system76/thelio/Thelio Prime N1(nebula19)/Thelio Main Signal Wiring/Dual 4 pin dupont.jpeg

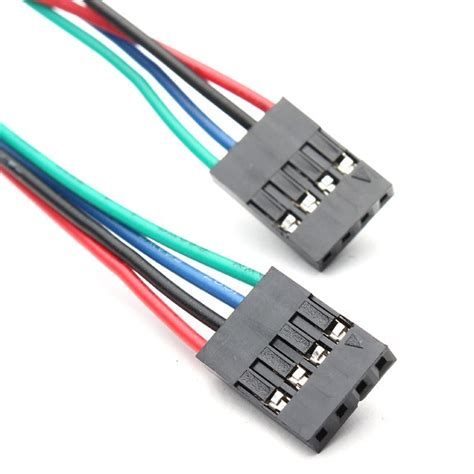
Thelio Prime N1(nebula19)/Thelio Main Signal Wiring/Dual 4 pin dupont.jpeg
