system76/thelio/Thelio Prime N2/README.md

# Thelio Prime N2

## OSHWA Numbers

- Thelio Prime N2: US002861

## Parts Index

| Part Number | Part Name |
|---|---|
| PN-000122 | Badge |
| PN-000652 | Front IO Frame |
| PN-000666 | Steel Magnet Tab |
| PN-000676 | Sqare Magnet Washer |
| PN-000688 | Prime Chassis Top |
| PN-000689 | Prime Right Side Mesh |
| PN-000690 | Prime GPU Brace |
| PN-000692 | Prime R5 N2 IO Shield |
| PN-000693 | Prime Punched Left External Panel |
| PN-000694 | Prime Front Glass Panel |
| PN-000695 | Prime Foot Bar |
| PN-000696 | Prime Mesh Right External Magnet Bracket |
| PN-000697 | Prime Top Magnet Bracket |
| PN-000698 | Prime Small PCI Bracket |
| PN-000699 | Prime Punched Left External Magnet Bracket |
| PN-000700 | Prime Bottom PEM Panel |
| PN-000701 | Prime PCI Mount |
| PN-000703 | Prime Chassis Front |
| PN-000705 | Prime Chassis Bottom |
| PN-000706 | Prime Bottom Fan Bracket |
| PN-000707 | Prime Top Fan Brace |
| PN-000708 | Prime Right Panel Filter Bracket |
| PN-000709 | Prime Chassis Rear |
| PN-000710 | Prime Chassis Main |
| PN-000711 | Prime Mesh Right External Panel |
| PN-000713 | Prime PSU Access Panel |
| PN-000714 | Prime Bottom Magnetic Bracket |
| PN-000715 | Prime PCI Mounting Bracket |
