system76/thelio/Thelio Mira/Thelio Mira/README.md

# Thelio Mira

## OSHWA Numbers

- Thelio Mira: US002790 

| Part Number | Part Name |
|---|---|
| PN-000122 | Badges-tabbed |
| PN-000518 | Drive Cage Cover |
| PN-000520 | Drive Cage |
| PN-000634 | Chassis Bottom |
| PN-000635 | GPU Bracket |
| PN-000636 | Bottom Rear Guide Bracket |
| PN-000637 | GPU Mounting Slot Bracket |
| PN-000638 | 3.5 inch Drive Back Plate |
| PN-000639 | 3.5 inch Drive Cover Plate  |
| PN-000640 | 3.5 inch Drive Cage |
| PN-000641 | Mira R4 IO Shield |
| PN-000643 | Chassis Main |
| PN-000644 | Chassis Rear |
| PN-000645 | Chassis Front |
| PN-000646 | Chassis Top |
| PN-000647 | Left External |
| PN-000648 | Right External |
| PN-000650 | Glass Front Panel |
| PN-000651 | Drive Cage Mounting Plate |
| PN-000652 | Front IO Frame |
| PN-000653 | GPU Arm Bracket |
| PN-000654 | GPU Ridge Plate |
| PN-000655 | GPU Finger |
| PN-000656 | PCI Mount |
| PN-000657 | Side Magnetic Tab |
| PN-000658 | Front Pull Tab |
| PN-000659 | PCI Bracket |
| PN-000660 | 1U Slot Cover |
| PN-000661 | Bottom Front Guide Tab |
| PN-000662 | Bottom Magnetic Bracket |
| PN-000663 | Top Magnetic Bracket |
| PN-000664 | 2.5 in Drive Cage Cover |
| PN-000665 | AIO Bracket |
| PN-000666 | Flat Magnet Tab |
| PN-000668 | Side Bottom External Guide  |
| PN-000669 | PCI Bracket Guide |
