system76/thelio/Thelio Massive/CAD/Extrusions/README.md

# Parts Index

| Part Number | Part Name |
|---|---|
| MSVEXTALU-001002 | Rear Right Extrusion |
| MSVEXTALU-002002 | Rear Left Extrusion |
| MSVEXTALU-003002 | Front Left Extrusion |
| MSVEXTALU-004002 | Front Right Extrusion |
