system76/thelio/Thelio Prime N1(nebula19)/CAD/Internal/README.md

# Parts Index

| Part Number | Part Name |
|---|---|
| PN-000009 | PCI Mount |
| PN-000010 | PCI Bracket |
| PN-000505 | CPU Duct Main |
| PN-000506 | CPU Duct Hood |
| PN-000507 | Chassis Main |
| PN-000509 | Chassis Rear Plate |
| PN-000510 | CPU Duct Fan Bracket |
| PN-000515 | Chassis Bottom |
| PN-000517 | Top IO Brace |
| PN-000518 | Chassis Top Brace |
| PN-000557 | 3D Printed Thelio Spacer 2  |
| PN-000558 | 3D Printed Thelio Spacer 1  |
| PN-000567 | Horizontal Brace |
| PN-000584 | GPU Arm |
| PN-000585 | GPU Arm Finger |
| PN-000595 | Thelio-R4 IO Shield |
