system76/thelio/Thelio Mega/N1_US000677/R2/Internal/README.md

# Parts Index

| Part Number | Part Name |
|---|---|
| PN-000024 | Drive Cage Cover |
| PN-000040 | Drive Cage |
| PN-000091 | PCI Mount |
| PN-000092 | Mega Foot Bar |
| PN-000097 | Chassis Bottom |
| PN-000098 | Side Intake Brace Bracket |
| PN-000099 | Chassis Brace |
| PN-000100 | PCI Bracket |
| PN-000101 | PSU Brace |
| PN-000102 | GPU Main Brace |
| PN-000122 | Product Badges |
| PN-000277 | GPU Brace Arm - Straight  |
| PN-000302 | Chassis Rear Plate |
| PN-000304 | CPU Duct Hood |
| PN-000305 | CPU Duct Main |
| PN-000319 | Chassis Main |
| PN-000324 | Case Spacer (Wire Cover)  |
| PN-000459 | CPU Duct Fan Bracket |
| PN-000501 | Side Intake Fan Brace |
