system76/thelio/Thelio Mega/N2_US002652/R3/Internal/README.md

# Parts Index

| Part Number | Part Name |
|---|---|
| PN-000091 | PCI Mount |
| PN-000092 | Mega Foot Bar |
| PN-000100 | PCI Bracket |
| PN-000101 | PSU Brace |
| PN-000102 | GPU Main Brace |
| PN-000122 | Product Badges |
| PN-000277 | GPU Brace Arm - Straight  |
| PN-000335 | Internal Case Brace |
| PN-000459 | CPU Duct Fan Bracket |
| PN-000512 | Drive Cage Cover |
| PN-000525 | Drive Cage |
| PN-000556 | 3D Printed Case Spacer |
| PN-000565 | Chassis Main |
| PN-000566 | Chassis Rear Plate |
| PN-000571 | Chassis Bottom |
| PN-000588 | Fan PCBA Bracket |
| PN-000590 | Chassis Brace |
| PN-000591 | Horizontal Brace |
| PN-000592 | CPU Duct Hood |
| PN-000593 | CPU Duct Main |
| PN-000594 | Mega-R3 IO Shield |
