system76/thelio/Thelio Mega/N3_US002708/R4/Internal/README.md

# Parts Index

| Part Number | Part Name |
|---|---|
| PN-000091 | PCI Mount |
| PN-000100 | PCI Bracket |
| PN-000277 | GPU Brace Arm - Straight  |
| PN-000512 | Drive Cage Cover |
| PN-000525 | Drive Cage |
| PN-000556 | Front Case Spacer |
| PN-000604 | Chassis Main |
| PN-000605 | CPU Intake Duct Hood |
| PN-000606 | CPU Duct Siding |
| PN-000607 | CPU Duct Main |
| PN-000608 | CPU Duct Rear Fan Bracket |
| PN-000609 | Horizontal Brace |
| PN-000610 | Chassis Bottom |
| PN-000611 | Chassis Rear Plate |
| PN-000612 | PSU Chamber |
| PN-000613 | Bottom Stiffener Bracket  |
| PN-000614 | GPU Brace |
| PN-000615 | Top Chassis Brace |
| PN-000616 | Case Spacer |
| PN-000621 | Mega-R4 IO Shield |
