system76/thelio/Thelio Mira/Thelio Mira (nebula36,spark)/CAD/Internal/README.md

# Parts Index

| Part Number | Part Name |
|---|---|
| PN-000094 | 1U PCI Slot Covers |
| PN-000122 | Product Badge |
| PN-000335 | Internal Case Brace |
| PN-000376 | Chassis Top Brace |
| PN-000459 | CPU Duct Fan Bracket |
| PN-000512 | Drive Cage Cover |
| PN-000525 | Drive Cage |
| PN-000526 | Chassis Bottom |
| PN-000527 | Chassis Main |
| PN-000528 | Chassis Rear Plate |
| PN-000529 | CPU Duct Main |
| PN-000530 | CPU Duct Hood |
| PN-000532 | Horizontal Brace |
| PN-000556 | 3D Printed Case Spacer |
| PN-000559 | Drive Cage Spacer |
| PN-000560 | PCI Bracket |
| PN-000561 | PCI Mount |
