system76/thelio/Thelio Mira/Thelio Mira (nebula40,spark,astra)/astra/internal/README.md

# Parts Index

| Part Number | Part Name |
|---|---|
| PN-000597 | Astra IO Shield 10G Ethernet |
| PN-000598 | CPU Duct Main |
| PN-000599 | CPU Duct Hood |
| PN-000600 | CPU Duct Fan Bracket |
| PN-000601 | Astra IO Shield SFP+ |
