system76/thelio/Thelio Mira/Thelio Mira (nebula40,spark,astra)/common/case/README.md

# Parts Index

| Part Number | Part Name |
|---|---|
| PN-000255 | Accent Panel Carrier |
| PN-000259 | Accent Panel |
| PN-000537 | Accent Panel Carrier Holder |
| PN-000577 | Right Side |
| PN-000578 | Left Side |
| PN-000579 | Top Bracket |
