system76/thelio/Thelio Mira/Thelio Mira (nebula40,spark,astra)/common/internal/README.md

# Parts Index

| Part Number | Part Name |
|---|---|
| PN-000094 | 1U PCI Slot Cover |
| PN-000101 | PSU Brace |
| PN-000122 | Product Badge |
| PN-000528 | Chassis Rear Plate |
| PN-000560 | PCI Bracket |
| PN-000561 | PCI Mount |
| PN-000573 | Chassis Top Brace |
| PN-000575 | Chassis Bottom |
| PN-000582 | Horizontal Brace |
| PN-000603 | Chassis Main |
