system76/thelio/Thelio Mira/Thelio Mira (nebula40,spark,astra)/mira,spark,nebula40/internal/README.md

# Parts Index

| Part Number | Part Name |
|---|---|
| PN-000457 | Mira-B4 IO Shield |
| PN-000459 | CPU Duct Fan Bracket |
| PN-000512 | Drive Cage Cover |
| PN-000525 | Drive Cage |
| PN-000530 | CPU Duct Hood |
| PN-000559 | Drive Cage Spacer |
| PN-000562 | Spark-B1 IO Shield |
| PN-000576 | CPU Duct Main |
| PN-000587 | Spark-R1 IO Shield |
