system76/thelio/Thelio Mega/N1_US000677/R1/CAD/Extrusions/README.md

# Parts Index

| Part Number | Part Name |
|---|---|
| MGAEXTALU-001001 | Rear Right Extrusion |
| MGAEXTALU-002001 | Rear Left Extrusion |
| MGAEXTALU-003001 | Front Left Extrusion |
| MGAEXTALU-004001 | Front Right Extrusion |
