system76/thelio/Thelio Prime N1(nebula19)/Thelio Main Power Supply/Thelio Main Power Supply Wires.odt

Power Supply Power Cables

Thelio Main

Spec version 2

All wire lengths specified from the inside of the connectors.

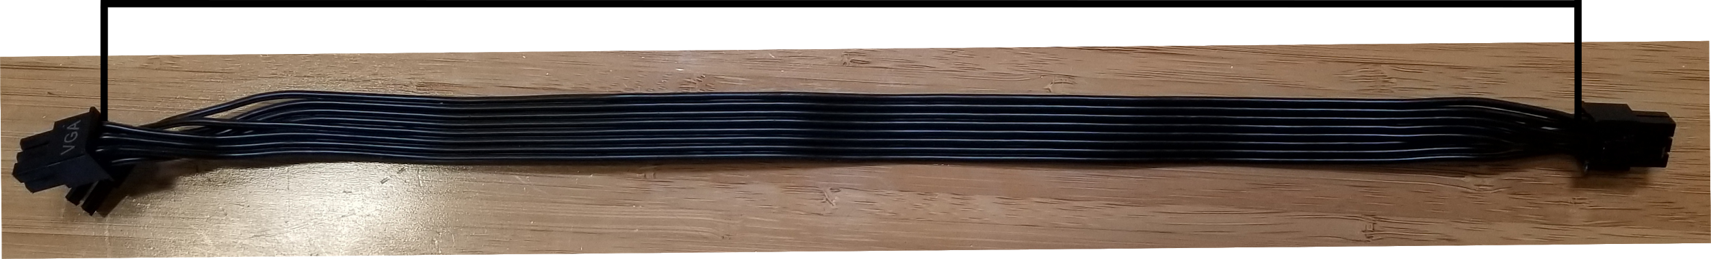
[picture p3: figure]

Cables and connectors are are to be black. Cables are to be braided.

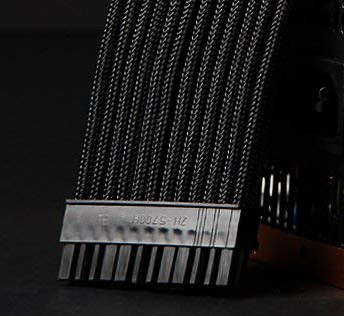
[picture p4: figure]
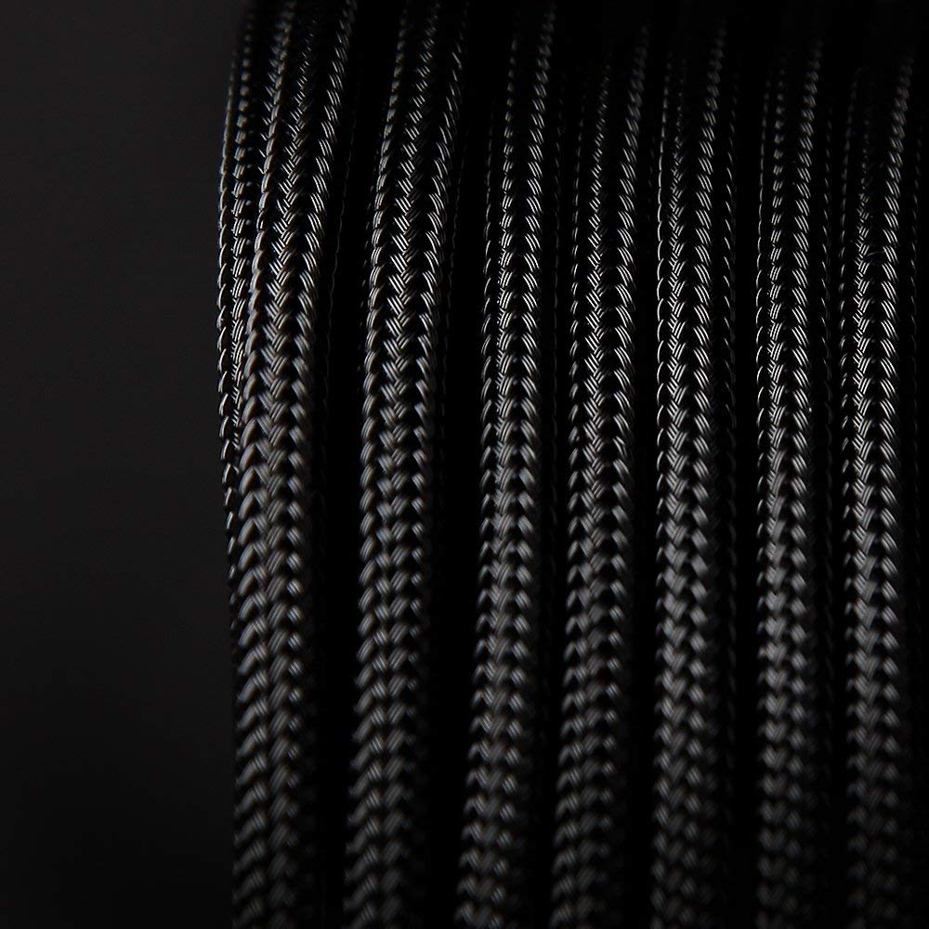
[picture p5: figure]

CPU Power - 520mm

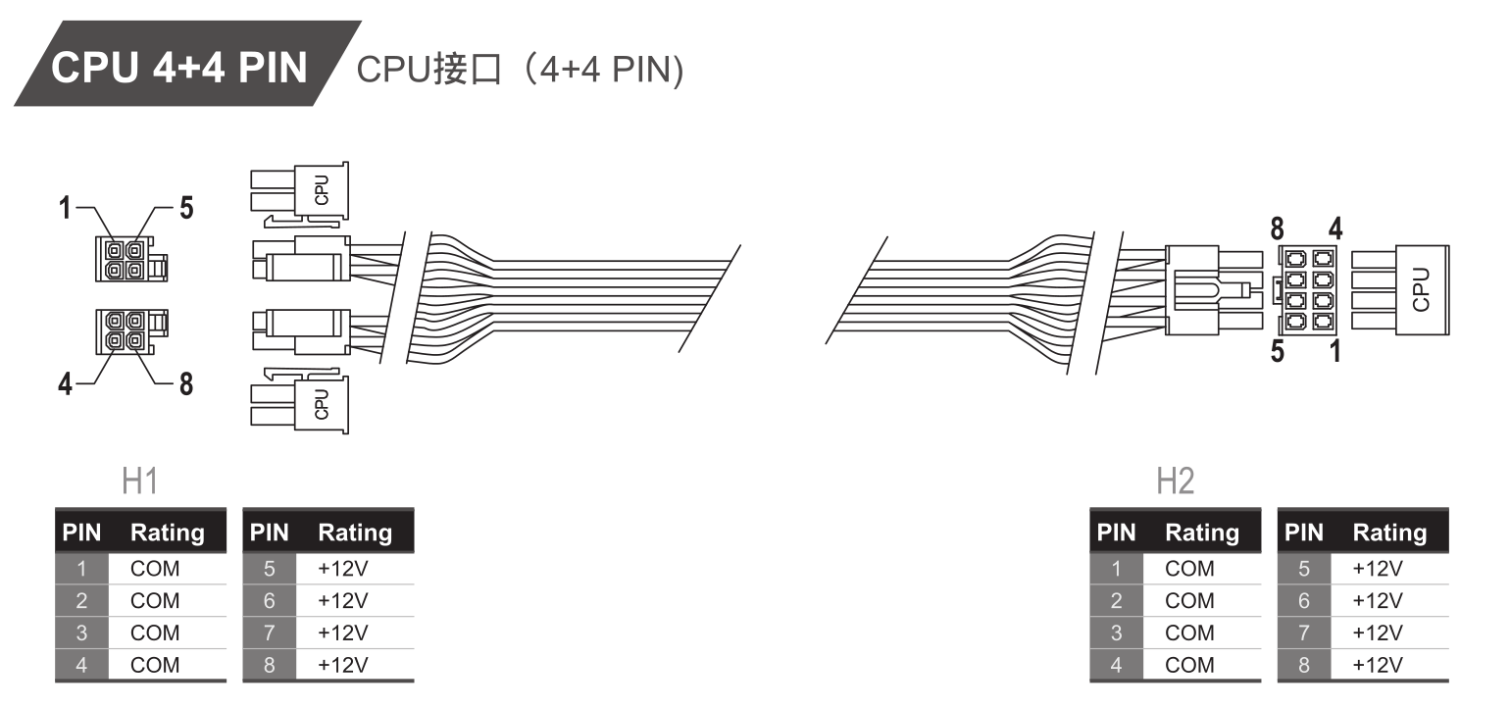
[picture p6: figure]

Mainboard Power - 440mm

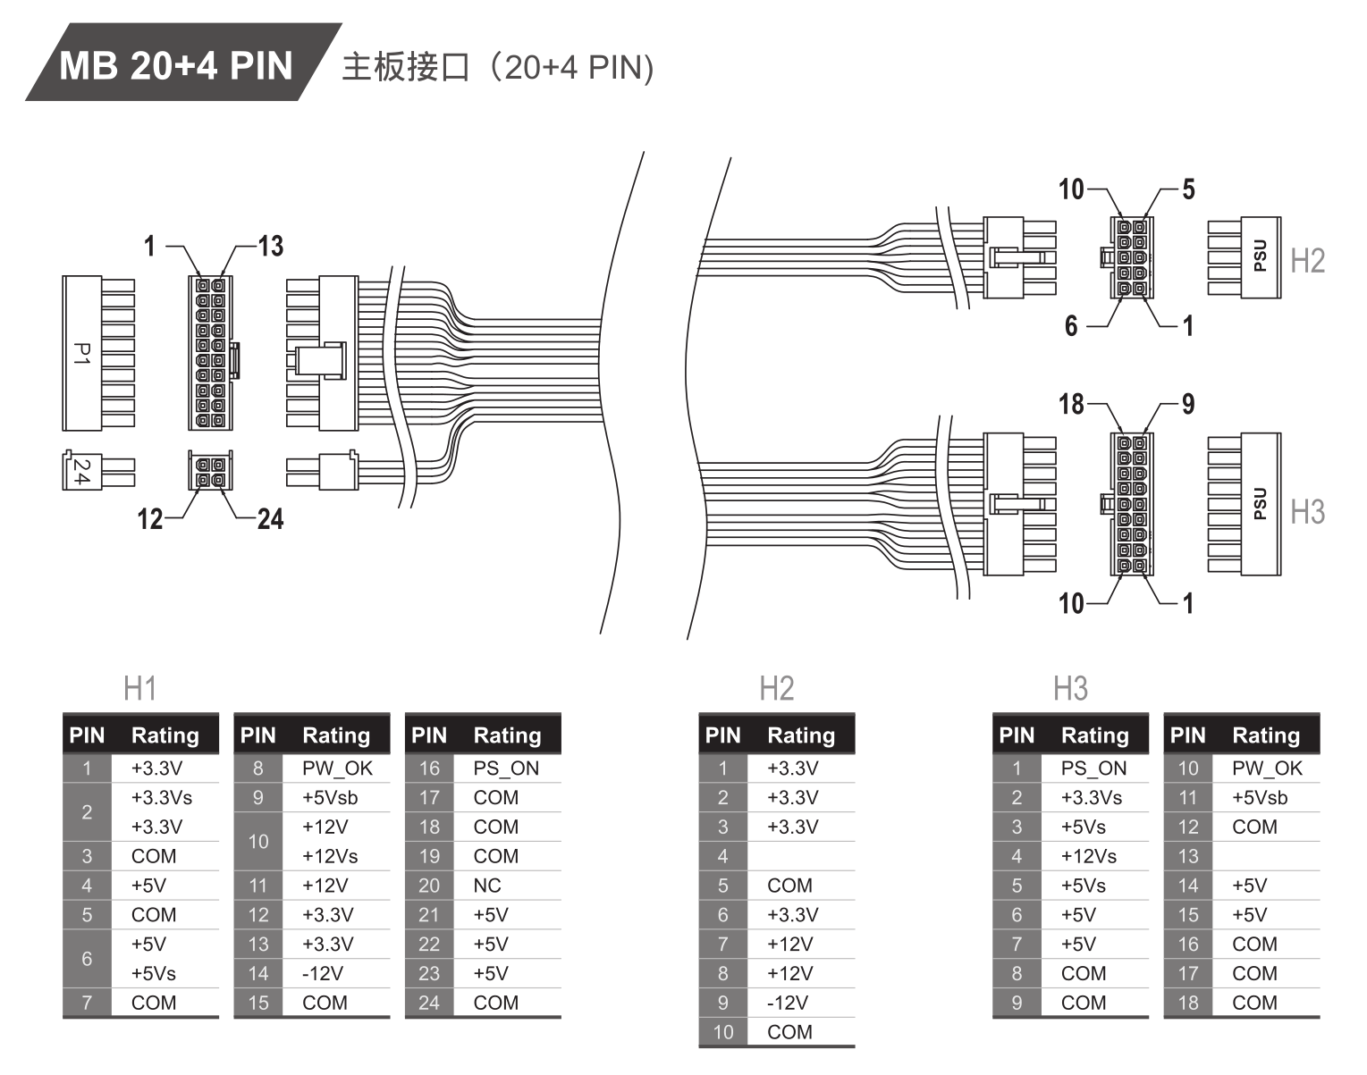
[picture p7: figure]

VGA - 235mm UPDATED - 6 pin PS connector

1 5 6 3
2 6 5 2
3 7 4 1
4 8

Floppy connector - UPDATED - 270mm

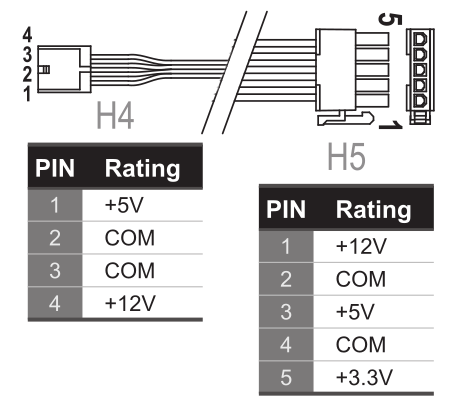
[picture p8: figure]
