system76/thelio/Thelio Major (nebula49)/CAD/Case/README.md

# Parts Index

| Part Number | Part Name |
|---|---|
| PN-000260 | Accent Panel |
| PN-000263 | Accent Panel Carrier |
| PN-000544 | Left Side |
| PN-000545 | Right Side |
| PN-000546 | Accent Panel Carrier Holder |
| PN-000547 | Top |
| PN-000548 | Top Bracket |
