system76/thelio/Thelio Prime N1(nebula19)/CAD/Case/README.md

# Parts Index

| Part Number | Part Name |
|---|---|
| PN-000252 | Accent Panel Carrier |
| PN-000257 | Accent Panel |
| PN-000520 | Accent Panel Carrier Holder |
| PN-000521 | Left Side |
| PN-000522 | Right Side |
| PN-000523 | Top Bracket |
| PN-000524 | Top |
