system76/thelio/Thelio Mira/Thelio Mira (nebula36,spark)/CAD/Case/README.md

# Parts Index

| Part Number | Part Name |
|---|---|
| PN-000255 | Accent Panel Carrier |
| PN-000259 | Accent Panel |
| PN-000533 | Top |
| PN-000534 | Top Bracket |
| PN-000535 | Left Side |
| PN-000536 | Right Side |
| PN-000537 | Accent Panel Carrier Holder |
