system76/thelio/Thelio Common/Screws and standoff/10mm self tapping fan screw.png

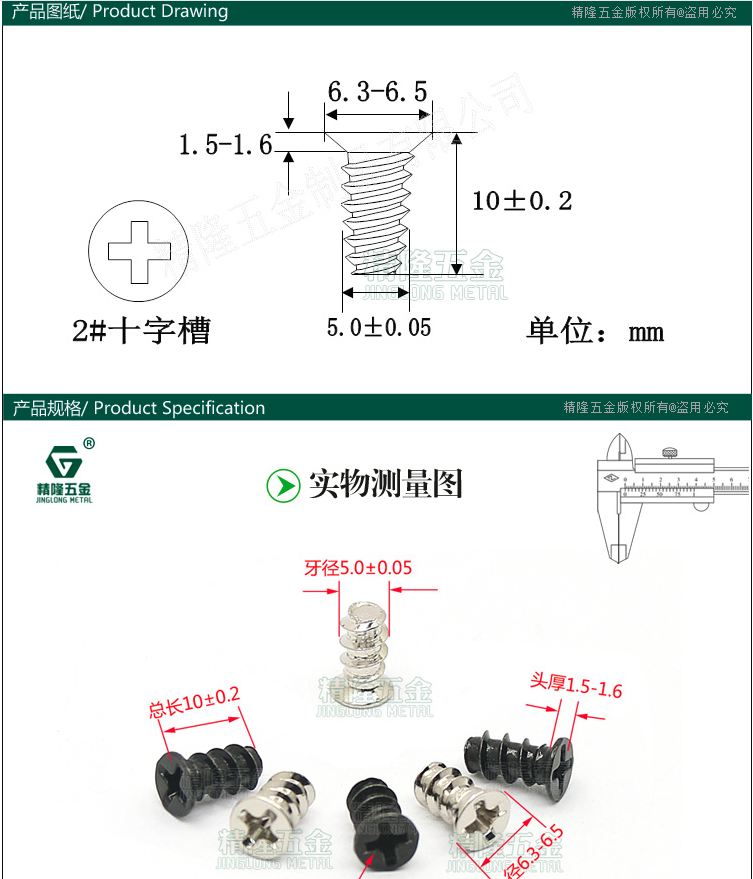
Thelio Common/Screws and standoff/10mm self tapping fan screw.png
