system76/thelio/Thelio Common/Screws and standoff/HD screw gromets.jpg

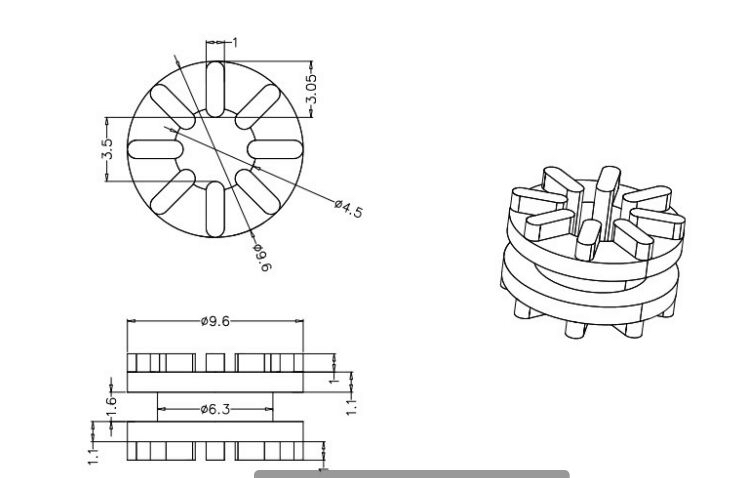
Thelio Common/Screws and standoff/HD screw gromets.jpg
