system76/thelio/Thelio Common/Screws and standoff/M3 HD screws.png

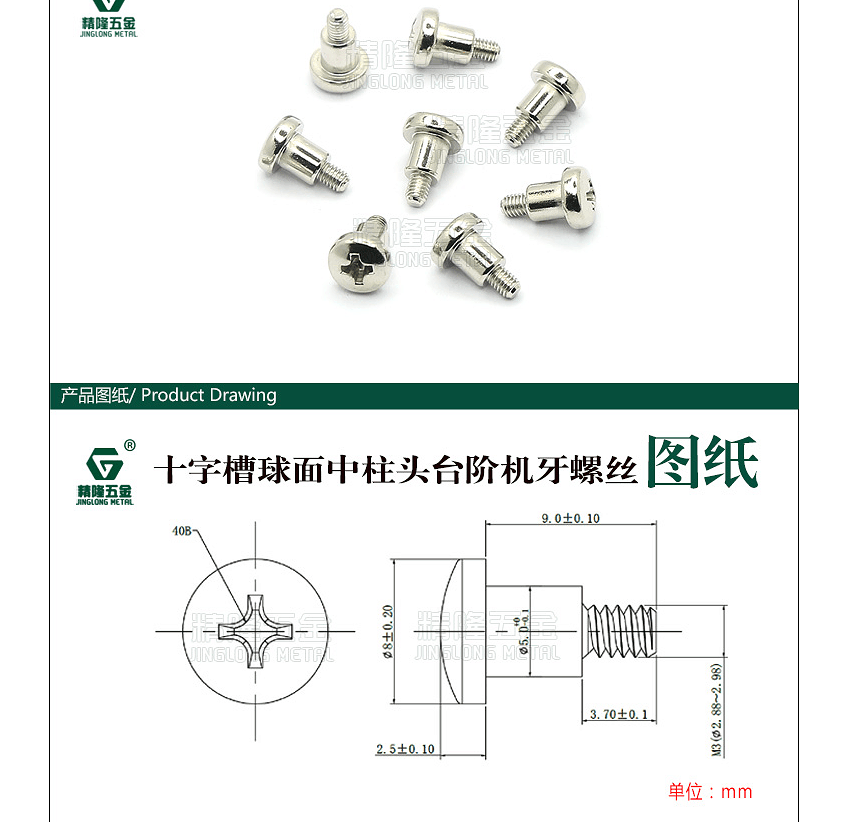
Thelio Common/Screws and standoff/M3 HD screws.png
