system76/thelio/Thelio Common/Screws and standoff/M3 x 10mm thumb screw.png

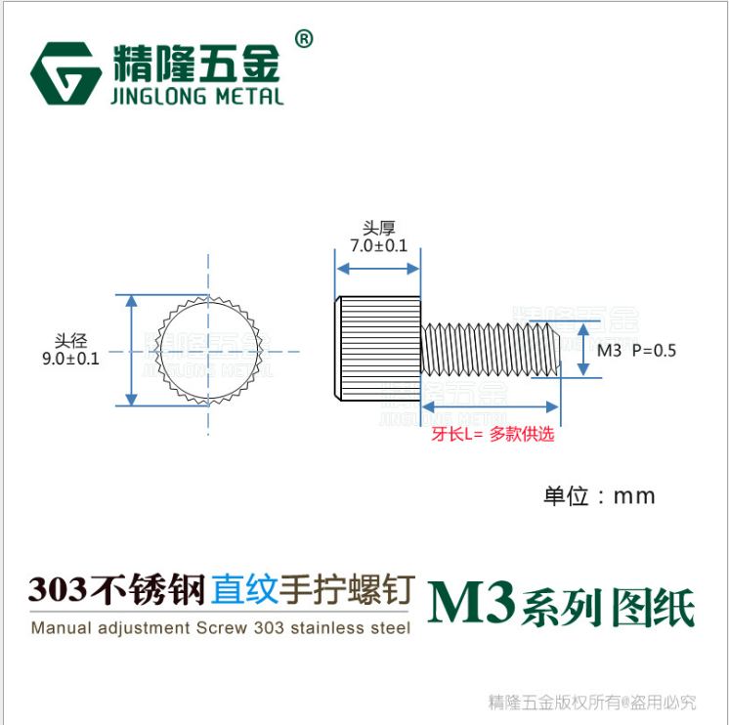
Thelio Common/Screws and standoff/M3 x 10mm thumb screw.png
