system76/thelio/Thelio Common/Screws and standoff/M4 x 10MM standoff.png

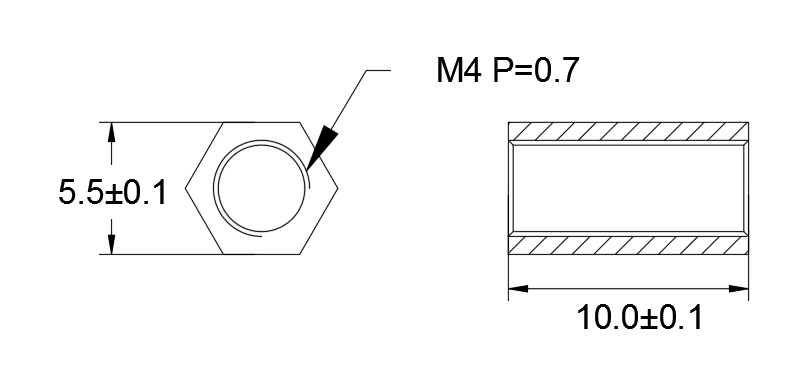
Thelio Common/Screws and standoff/M4 x 10MM standoff.png
