system76/thelio/Thelio Common/Screws and standoff/M4 x.7 x 5 mm screw.png

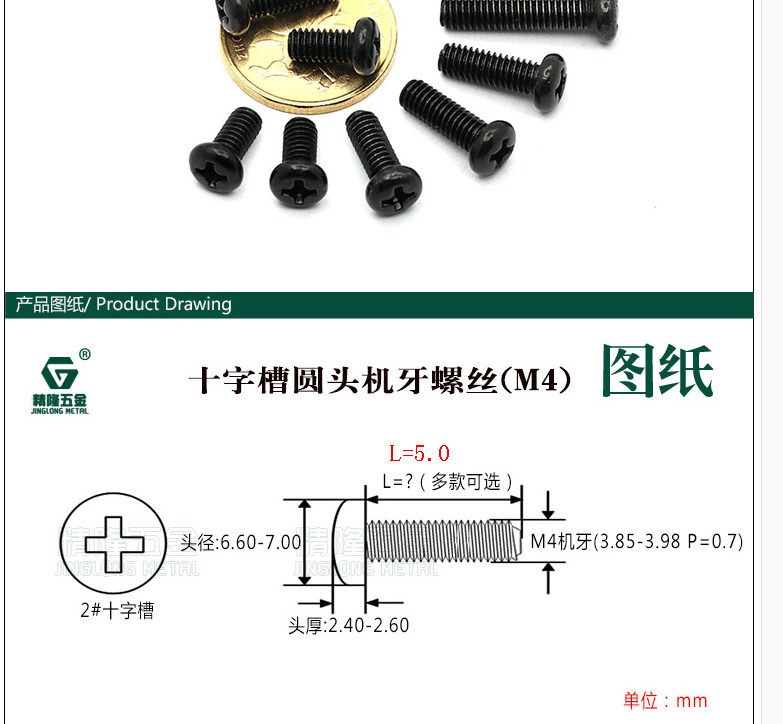
Thelio Common/Screws and standoff/M4 x.7 x 5 mm screw.png
