system76/thelio/Thelio Common/Screws and standoff/rivet.jpg

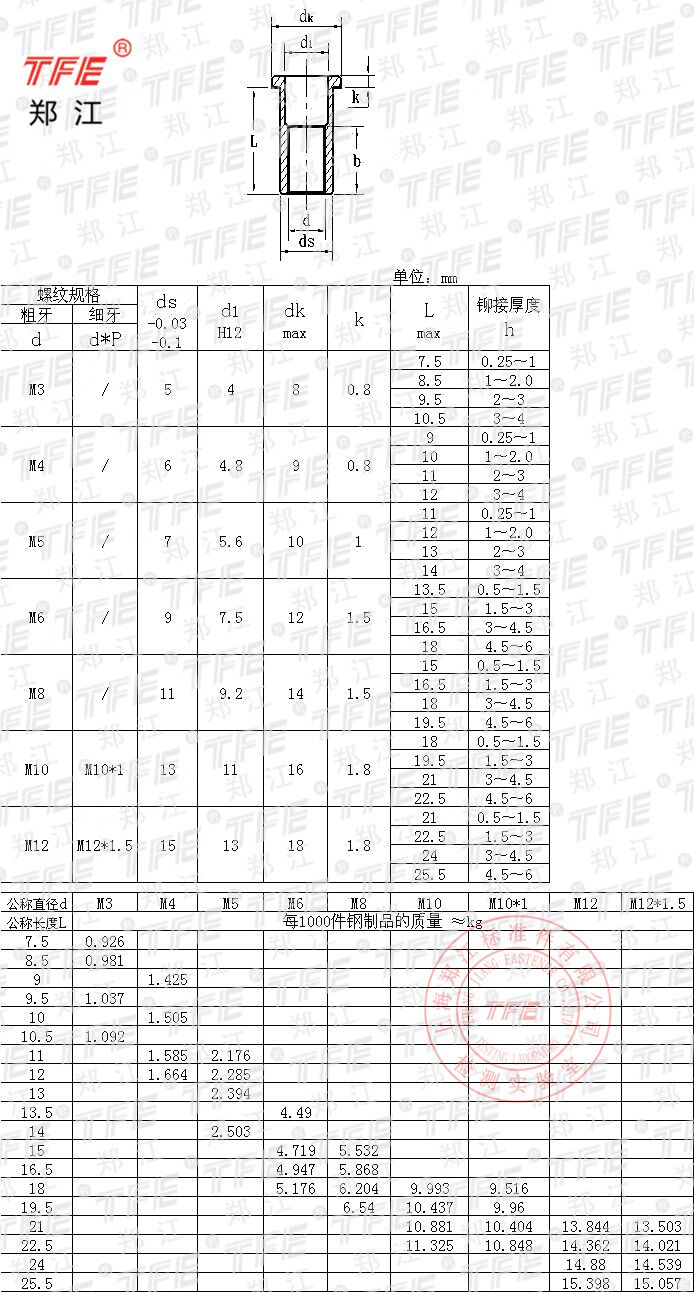
Thelio Common/Screws and standoff/rivet.jpg
