system76/thelio/Thelio Common/Screws and standoff/Steel m3 rivet nuts.png

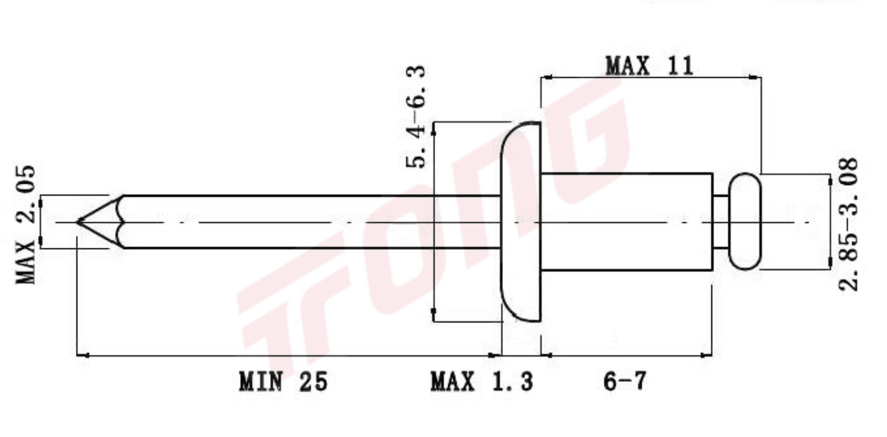
Thelio Common/Screws and standoff/Steel m3 rivet nuts.png
