system76/thelio/Thelio Common/Wireless Antennas/internal wireless spec.png

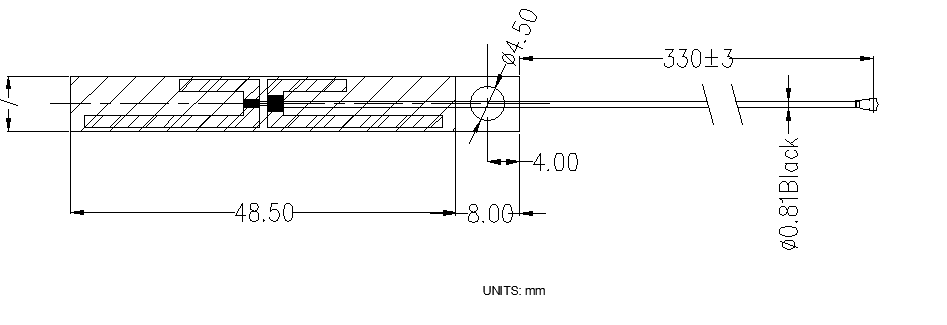
Thelio Common/Wireless Antennas/internal wireless spec.png
