system76/thelio/Thelio Common/Fan Spacers and Wireless Signal Window/140MM Fan Spacer.dxf

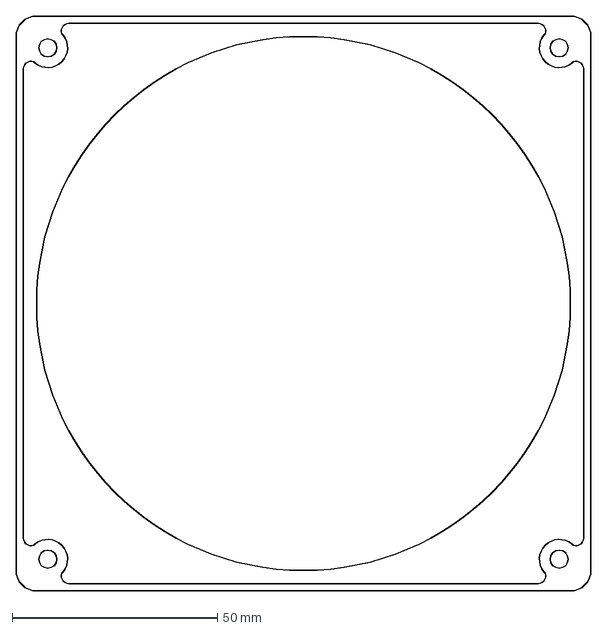
[picture p18: CAD file, 2018-11-01]
Thelio Common/Fan Spacers and Wireless Signal Window/140MM Fan Spacer.dxf
140.0 x 140.0 mm
