system76/thelio/Thelio Common/Fan Spacers and Wireless Signal Window/120MM Fan Spacer.dxf

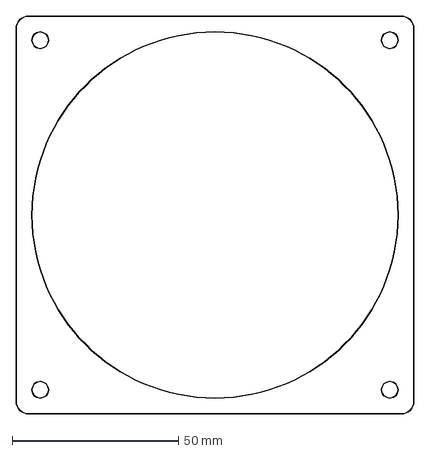
[picture p19: CAD file, 2018-11-01]
Thelio Common/Fan Spacers and Wireless Signal Window/120MM Fan Spacer.dxf
119.5 x 119.5 mm
