system76/thelio/Thelio Common/Fan Spacers and Wireless Signal Window/Thelio Wifi Window.dxf

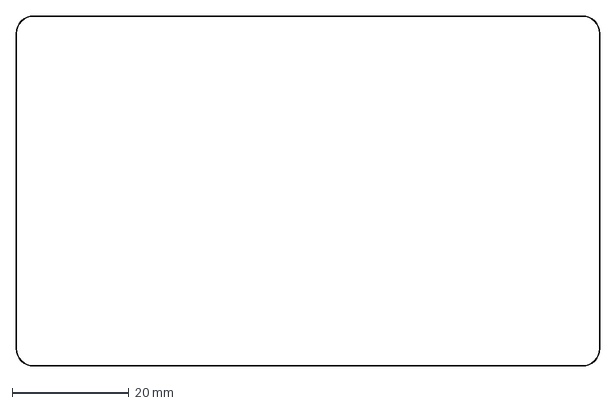
[picture p20: CAD file, 2018-11-01]
Thelio Common/Fan Spacers and Wireless Signal Window/Thelio Wifi Window.dxf
100.0 x 60.0 mm
