system76/thelio/(list of files, cad)

Other CAD files:
Thelio Mega/N3_US002708/R4/Mega R4 Component Assembly v55.step
Thelio Mira/Thelio Mira (nebula40,spark,astra)/common/internal/Mira Extended Assembly (N3) v16.step
Thelio Prime N2/Prime R5 N2 Assembly.step
Thelio Mira/Thelio Mira/Mira Magnet Assembly.step
Thelio Mira/Thelio Mira/2x cage assembly v20.step
Thelio Common/Power Button Mount/Pwr_Button_Mount_Lower.step
Thelio Common/Thelio Foot/PN-000438 & PN-000437 v3.step
Thelio Common/Top IO/Top IO Mockup v11.step
Thelio Major (nebula49)/CAD/Case/PN-000547 v21.step
Thelio Major (nebula49)/CAD/Internal/PN-000540 v33.step
Thelio Massive/CAD/Extrusions/MSVEXTALU-004002.step
Thelio Massive/CAD/STEP External/MSVALU-004003.step
Thelio Massive/CAD/STEP Internal/MGAALU-012012.step
Thelio Mega/N1_US000677/R1/CAD/Extrusions/MGAEXTALU-002001.step
Thelio Mega/N1_US000677/R1/CAD/STEP External/MAJALU-017004 v3.step
Thelio Mega/N1_US000677/R1/CAD/STEP Internal R1/MGAALU-026001.step
Thelio Mega/N1_US000677/R1/CAD/V1-1.step
Thelio Mega/N1_US000677/R2/Internal/PN-000122 v12.step
Thelio Mega/N2_US002652/R3/Internal/PN-000593 v5.step
Thelio Mega/N3_US002708/R4/Internal/PN-000612 v9.step
Thelio Mira/Thelio Mira (nebula36,spark)/CAD/Case/PN-000535 v24.step
Thelio Mira/Thelio Mira (nebula36,spark)/CAD/Internal/PN-000561 v20.step
Thelio Mira/Thelio Mira (nebula40,spark,astra)/astra/case/PN-000596 v2.step
Thelio Mira/Thelio Mira (nebula40,spark,astra)/astra/internal/PN-000601 v5.step
Thelio Mira/Thelio Mira (nebula40,spark,astra)/common/case/PN-000259 v2.step
Thelio Mira/Thelio Mira (nebula40,spark,astra)/common/internal/PN-000603 v2.step
Thelio Mira/Thelio Mira (nebula40,spark,astra)/mira,spark,nebula40/case/PN-000580 v2.step
Thelio Mira/Thelio Mira (nebula40,spark,astra)/mira,spark,nebula40/internal/PN-000587 v22.step
Thelio Mira/Thelio Mira/PN-000648 v17.step
Thelio Prime N1(nebula19)/CAD/Case/PN-000257 v3.step
Thelio Prime N1(nebula19)/CAD/Internal/PN-000506 v21.step
Thelio Prime N2/PN_000696 v13.step
Thelio Common/Power Button Mount/Pwr_Button_Mount_Upper.step
Thelio Major (nebula49)/CAD/Case/PN-000545 v9.step
Thelio Major (nebula49)/CAD/Internal/PN-000367 v32.step
Thelio Massive/CAD/Extrusions/MSVEXTALU-002002.step
Thelio Massive/CAD/STEP External/MSVALU-001002.step
Thelio Massive/CAD/STEP Internal/MGAALU-018005.step
Thelio Mega/N1_US000677/R1/CAD/Extrusions/MGAEXTALU-003001.step
Thelio Mega/N1_US000677/R1/CAD/STEP External/MAJALU-016004 v3.step
Thelio Mega/N1_US000677/R1/CAD/STEP Internal R1/MGAFIL-003001.step
Thelio Mega/N1_US000677/R2/Internal/PN-000091 v12.step
Thelio Mega/N2_US002652/R3/Internal/PN-000590 v9.step
Thelio Mega/N3_US002708/R4/Internal/PN-000621 v7.step
Thelio Mira/Thelio Mira (nebula36,spark)/CAD/Case/PN-000259 v2.step
Thelio Mira/Thelio Mira (nebula36,spark)/CAD/Internal/PN-000335 v7.step
Thelio Mira/Thelio Mira (nebula40,spark,astra)/astra/internal/PN-000599 v8.step
Thelio Mira/Thelio Mira (nebula40,spark,astra)/common/case/PN-000255 v15.step
Thelio Mira/Thelio Mira (nebula40,spark,astra)/common/internal/PN-000575 v12.step
Thelio Mira/Thelio Mira (nebula40,spark,astra)/mira,spark,nebula40/internal/PN-000562 v11.step
Thelio Mira/Thelio Mira/External Magnet Con Holder v6.step
Thelio Prime N1(nebula19)/CAD/Case/PN-000252 v17.step
Thelio Prime N1(nebula19)/CAD/Internal/PN-000557 v2.step
Thelio Prime N2/PN_000698 v3.step
Thelio Major (nebula49)/CAD/Case/PN-000548 v26.step
Thelio Major (nebula49)/CAD/Internal/PN-000543 v21.step
Thelio Massive/CAD/Extrusions/MSVEXTALU-003002.step
Thelio Massive/CAD/STEP External/MSVALU-012006.step
Thelio Massive/CAD/STEP Internal/MSVALU-006004.step
Thelio Mega/N1_US000677/R1/CAD/Extrusions/MGAEXTALU-001001.step
Thelio Mega/N1_US000677/R1/CAD/STEP External/MGAALU-004001.step
Thelio Mega/N1_US000677/R1/CAD/STEP Internal R1/MGAFIL-004001.step
Thelio Mega/N1_US000677/R2/Internal/PN-000101 v15.step
Thelio Mega/N2_US002652/R3/Internal/PN-000592 v3.step
Thelio Mega/N3_US002708/R4/Internal/PN-000556 v5.step
Thelio Mira/Thelio Mira (nebula36,spark)/CAD/Case/PN-000537 v7.step
Thelio Mira/Thelio Mira (nebula36,spark)/CAD/Internal/PN-000094 v19.step
Thelio Mira/Thelio Mira (nebula40,spark,astra)/astra/internal/PN-000598 v13.step
Thelio Mira/Thelio Mira (nebula40,spark,astra)/common/case/PN-000577 v2.step
Thelio Mira/Thelio Mira (nebula40,spark,astra)/mira,spark,nebula40/internal/PN-000576 v8.step
Thelio Mira/Thelio Mira/Lower Foot v4.step
Thelio Prime N1(nebula19)/CAD/Case/PN-000520 v3.step
Thelio Prime N1(nebula19)/CAD/Internal/PN-000585 v13.step
Thelio Prime N2/PN_000122 v12.step
Thelio Major (nebula49)/CAD/Case/PN-000544 v19.step
Thelio Major (nebula49)/CAD/Internal/PN-000541 v21.step
Thelio Massive/CAD/Extrusions/MSVEXTALU-001002.step
Thelio Massive/CAD/STEP External/MAJALU-016004.step
Thelio Massive/CAD/STEP Internal/MGAALU-020002.step
Thelio Mega/N1_US000677/R1/CAD/Extrusions/MGAEXTALU-004001.step
Thelio Mega/N1_US000677/R1/CAD/STEP External/MGAALU-001001.step
Thelio Mega/N1_US000677/R1/CAD/STEP Internal R1/MGAALU-012007.step
Thelio Mega/N1_US000677/R2/Internal/PN-000319 v18.step
Thelio Mega/N2_US002652/R3/Internal/PN-000594 v12.step
Thelio Mega/N3_US002708/R4/Internal/PN-000605 v11.step
Thelio Mira/Thelio Mira (nebula36,spark)/CAD/Case/PN-000534 v28.step
Thelio Mira/Thelio Mira (nebula36,spark)/CAD/Internal/PN-000376 v24.step
Thelio Mira/Thelio Mira (nebula40,spark,astra)/astra/internal/PN-000597 v14.step
Thelio Mira/Thelio Mira (nebula40,spark,astra)/common/case/PN-000579 v2.step
Thelio Mira/Thelio Mira (nebula40,spark,astra)/common/internal/PN-000122 v12.step
Thelio Mira/Thelio Mira (nebula40,spark,astra)/mira,spark,nebula40/internal/PN-000457 v17.step
Thelio Mira/Thelio Mira/PN-000634 v11.step
Thelio Prime N1(nebula19)/CAD/Case/PN-000522 v13.step
Thelio Prime N1(nebula19)/CAD/Internal/PN-000567 v7.step
Thelio Prime N2/PN_000694 v8.step
Thelio Major (nebula49)/CAD/Case/PN-000263 v6.step
Thelio Major (nebula49)/CAD/Internal/PN-000542 v25.step
Thelio Massive/CAD/STEP External/MSVALU-003004.step
Thelio Massive/CAD/STEP Internal/MGAALU-019005.step
Thelio Mega/N1_US000677/R1/CAD/STEP External/MGAALU-003001.step
Thelio Mega/N1_US000677/R1/CAD/STEP Internal R1/MGAFIL-002001.step
Thelio Mega/N1_US000677/R2/Internal/PN-000277 v2.step
Thelio Mega/N2_US002652/R3/Internal/PN-000588 v5.step
Thelio Mega/N3_US002708/R4/Internal/PN-000606 v11.step
Thelio Mira/Thelio Mira (nebula36,spark)/CAD/Case/PN-000255 v15.step
Thelio Mira/Thelio Mira (nebula36,spark)/CAD/Internal/PN-000559 v4.step
Thelio Mira/Thelio Mira (nebula40,spark,astra)/astra/internal/PN-000600 v6.step
Thelio Mira/Thelio Mira (nebula40,spark,astra)/common/case/Mira Case N3 - Accent case extended 40 mm v3.step
Thelio Mira/Thelio Mira (nebula40,spark,astra)/common/internal/PN-000582 v5.step
Thelio Mira/Thelio Mira (nebula40,spark,astra)/mira,spark,nebula40/internal/PN-000530 v17.step
Thelio Mira/Thelio Mira/PN_000668 v7.step
Thelio Prime N1(nebula19)/CAD/Case/PN-000524 v25.step
Thelio Prime N1(nebula19)/CAD/Internal/PN-000558 v2.step
Thelio Prime N2/PN_000697 v10.step
Thelio Major (nebula49)/CAD/Case/PN-000260 v1.step
Thelio Major (nebula49)/CAD/Internal/PN-000539 v18.step
Thelio Massive/CAD/STEP External/MSVALU-012005.step
Thelio Massive/CAD/STEP Internal/MSVALU-010006.step
Thelio Mega/N1_US000677/R1/CAD/STEP External/MGAALU-002001.step
Thelio Mega/N1_US000677/R1/CAD/STEP Internal R1/MGAALU-025002.step
Thelio Mega/N1_US000677/R2/Internal/PN-000102 v14.step
Thelio Mega/N2_US002652/R3/Internal/PN-000591 v8.step
Thelio Mega/N3_US002708/R4/Internal/PN-000277 v2.step
Thelio Mira/Thelio Mira (nebula36,spark)/CAD/Case/PN-000536 v15.step
Thelio Mira/Thelio Mira (nebula36,spark)/CAD/Internal/PN-000532 v25.step
Thelio Mira/Thelio Mira (nebula40,spark,astra)/common/case/PN-000537 v7.step
Thelio Mira/Thelio Mira (nebula40,spark,astra)/common/internal/PN-000094 v19.step
Thelio Mira/Thelio Mira (nebula40,spark,astra)/mira,spark,nebula40/internal/PN-000512 v13.step
Thelio Mira/Thelio Mira/PN-000661 v10.step
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
