system76/thelio/Thelio Massive/CAD/STEP External/README.md

# Parts Index

| Part Number | Part Name |
|---|---|
| MAJALU-016004 | Front Bracket |
| MSVALU-001002 | Front Panel |
| MSVALU-002007 | Top Panel |
| MSVALU-003004 | Left Panel |
| MSVALU-004003 | Right Panel |
| MSVALU-012005 | Left Bracket |
| MSVALU-12006 | Right Bracket |
