system76/thelio/Thelio Massive/CAD/STEP Internal/README.md

# Parts Index

| Part Number | Part Name |
|---|---|
| MGAALU-012012 | Horizontal Brace |
| MGAALU-018005 | Drive Cage Panel A |
| MGAALU-019005 | Drive Cage Panel B |
| MGAALU-020002 | Drive Cage Cover |
| MGAALU-021004 | Horizontal Brace Intake Baffle |
| MGAALU-024002 | Foot Bar |
| MGAALU-028001 | PSU Brace |
| MGAFIL-002001 | 3D Printed Horizontal Brace Spacer  |
| MSVALU-000091 | PCI Mount |
| MSVALU-005004 | Chassis Main |
| MSVALU-006004 | Chassis Bottom |
| MSVALU-007004 | Horizontal Brace Extension |
| MSVALU-010006 | CPU Duct |
| MSVALU-013006 | Chassis Top Fan Brace |
| MSVALU-014004 | Horizontal Brace Bracket |
| MSVALU-022003 | PCI Bracket |
