system76/thelio/Thelio Mega/N1_US000677/R1/CAD/STEP External/README.md

# Parts Index

| Part Number | Part Name |
|---|---|
| MAJALU-016004 | Front Bracket |
| MAJALU-017004 | Side Bracket |
| MGAALU-001001 | Front Panel |
| MGAALU-002001 | Top Panel |
| MGAALU-003001 | Left Panel |
| MGAALU-004001 | Right Panel |
