system76/thelio/Thelio Mega/N1_US000677/R1/CAD/STEP Internal R1/README.md

# Parts Index

| Part Number | Part Name |
|---|---|
| MGAALU-009005 | Chassis Main |
| MGAALU-011004 | Chassis Bottom |
| MGAALU-012007 | GPU Brace |
| MGAALU-012010 | Horizontal Brace |
| MGAALU-014005 | Horizontal Brace Bracket |
| MGAALU-017005 | Chassis Top Brace |
| MGAALU-018004 | Drive Cage |
| MGAALU-019002 | Drive Cage Side Panel |
| MGAALU-020002 | Drive Cage Cover |
| MGAALU-021003 | Horizontal Brace Intake Baffle |
| MGAALU-022002 | PCI Bracket |
| MGAALU-023001 | PSU Brace |
| MGAALU-024001 | Foot Bar |
| MGAALU-025002 | Horizontal Brace Drive Screw Cover  |
| MGAALU-026001 | PCI Mount |
| MGAALU-027001 | 2U PCI Slot Cover |
| MGAFIL-001003 | 3D Printed GPU Brace Arm Fingers |
| MGAFIL-002001 | 3D Printed Horizontal Brace Spacer  |
| MGAFIL-003001 | 3D Printed Drive Screw Cover Spacer |
| MGAFIL-004001 | 3D Printed GPU Brace Arm |
