system76/thelio/Thelio Major (nebula49)/Thelio Major Signal Wiring/wireless/wireless antenna.jpg

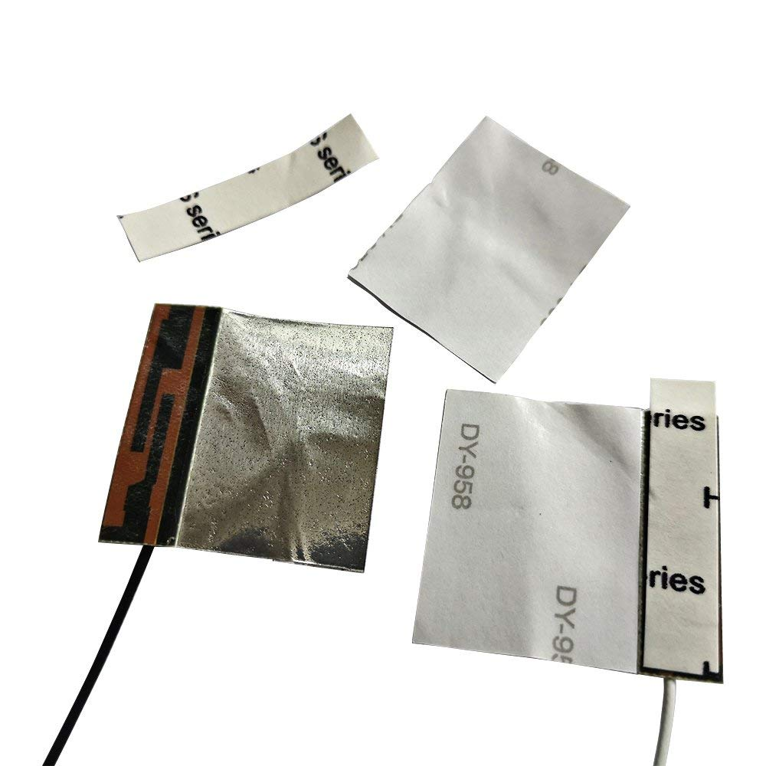
Thelio Major (nebula49)/Thelio Major Signal Wiring/wireless/wireless antenna.jpg
