system76/thelio/Thelio Prime N1(nebula19)/Thelio Main Signal Wiring/hd audio connector.jpg

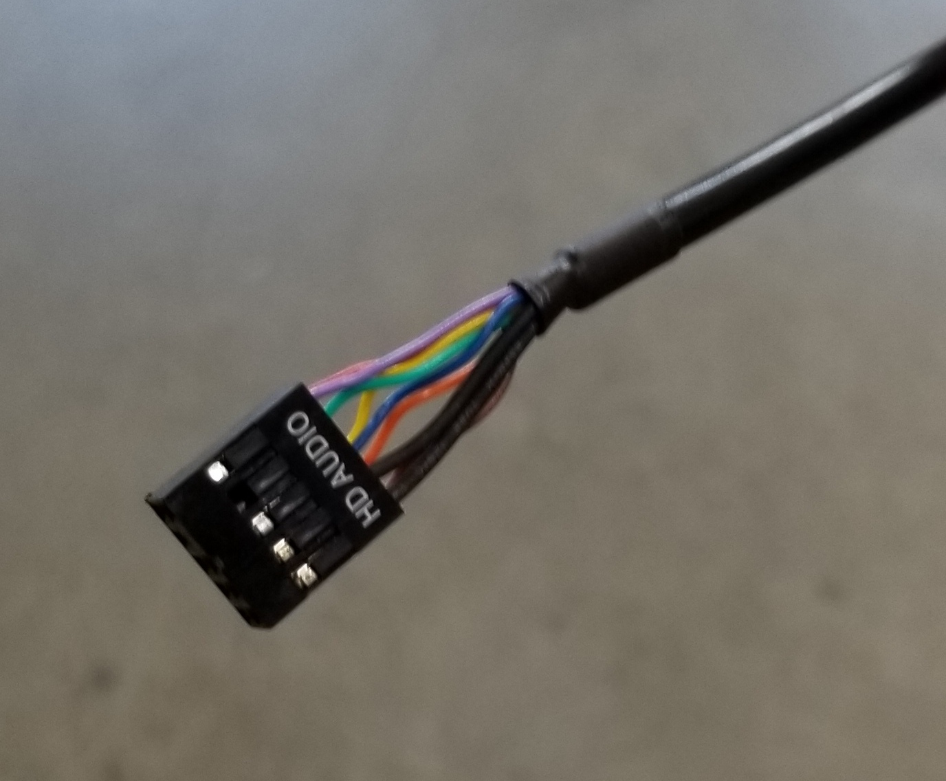
Thelio Prime N1(nebula19)/Thelio Main Signal Wiring/hd audio connector.jpg
