system76/thelio/Thelio Prime N1(nebula19)/Thelio Main Signal Wiring/usb 3.0 female connector.jpg

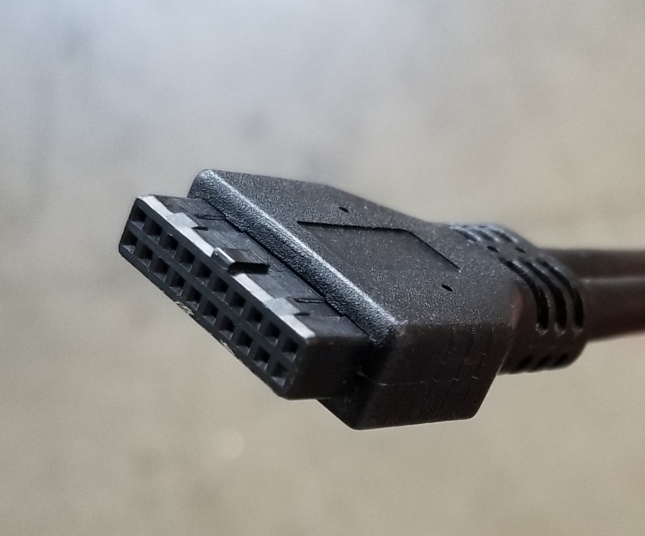
Thelio Prime N1(nebula19)/Thelio Main Signal Wiring/usb 3.0 female connector.jpg
