system76/thelio/(threads)

Thread 3 (2019-02-13):

looking for the ideal (lightweight) laptop for developers

pachamaltese, 2019-02-13:
# Looking for the perfect laptop (for developers)

## Introduction

After your Twitter [reply](https://twitter.com/system76/status/1095449280968617990) here are my thoughts about the perfect laptop.

## Thinkpads

IMO, the best laptops ever created and [MoMA](https://www.moma.org/collection/works/2168) is with me at this. However, after a long discussion with colleagues they could be improved with some small changes.

## Arrow keys

They should be fully sized, even if that requires to enlarge the keyboard area a bit more, as currently most laptops (i.e. Thinkpads) enlarge the bottom edge a bit. The same applies to key such as PgUp and PgDn.

## Fn keys

Unlike most Thinkpad users, my call is that fn button should be right to ctrl button as most users are used to that.

## Touchpad and numerical keyboard

The touchpad should be horizontally centered and there should be no numerical keyboard on a laptop, as it biases both the touchpad and the rest of the keyboard to the left, and therefore it promotes bad muscular habits.

Ideally, a touchpad without buttons is better. If it allows clicking without pressing but just touching, even better.

In an ideal world a good touchpad shall include a button next to it to turn on/off the device for three main purposes:

* saving battery when using the terminal for an extended period
* to disable it to prevent accidental clicking
* you want to save battery and don't need to use the touchpad at the moment

## Backlit keyboard

it helps a lot when it comes with white and/or green light. Red is acceptable while blue it not good at all.

## Display

A 14'' display seems to be ok and it's a relative consensus. Matte display are something really valuable just because glossy screens can stress eyes a lot.

## Processor and graphics

For Linux users, AMD is the way to go. NVIDIA card are problematic. I know Pop OS really simplifies the long fight with drivers, but keeping drivers up to date as it is required by different applications, is really complicated.

## Fingerprint reader

Anything that is Ubuntu-compatible is ok.

## Panel to control devices

In the case of Pop OS (what I use on a Thinkpad), it would be nice to have a panel that allows to disable/enable:

* wifi
* bluetooth
* touchpad
* webcam
* usb ports
* fingerprint reader

I know the wifi on/off function works ok, and it can be extended to other hardware devices.

Thread 4 (2019-03-09):

Graphic cards hanging down due missing holder

magdesign, 2019-03-09:
On my Thelio the graphics card is kind of hanging down.

To fix this, I made the first modification on the case:
Cutting 2x M3 threads and fit in a screw to hold the weight of the cards. See attached pictures.
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

brs17, 2019-03-13:
Thank you for the feedback @magdesign ! We really appreciate it.

Since you received your Thelio, we have since made some changes to the pcie bracket with a similar solution in mind (notice the ridges holding the graphics card up):

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

I expect the team to be in touch with you regarding these changes.

eric-s-raymond, 2019-05-18:
I've seen a similar issue with my Thelio.  Graphics card fell partway out of its slot when I had the machine case off and resting on its front so I could have easy access to the rear-side ports.  Clearly it wan't secured enough.

Closed 2019-05-18.

Thread 10 (2019-05-18):

Thelio case has no labeling on audio I/O jacks

eric-s-raymond, 2019-05-18:
Thelio case has no labeling on audio I/O jacks. This is an epic fail.  If I have to explain why, you should be ashamed of yourselves.

magdesign, 2019-05-18:
At least a sketch to download where all ports are labeled so we can figure out which port is what.

WatchMkr, 2019-05-18:
This is on the Thelio product roadmap.

magdesign, 2019-11-19:
Here is the sketch of which plug is for what:

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

found here on page 21: https://download.gigabyte.com/FileList/Manual/mb_manual_x399-designare-ex_e.pdf

CaryHertert, 2021-07-09:
@jgrano can we call this closed?  or at least duplicated by #22  #23 #26 #28

jgrano, 2021-07-09:
All new product releases are getting port labels.

Closed 2021-07-09.

Thread 11 (2019-05-18):

Thelio case doesn't use a standard I/O cutout on the rear edge.

eric-s-raymond, 2019-05-18:
This is not personally an issue for me.  But I've seen online comments by people who say it's a dealbreaker for them, and you should be aware of that.

WatchMkr, 2019-05-18:
We won't be moving to a I/O shield.

eric-s-raymond, 2019-05-18:
What's the advantage in the way it's done now?

Again, not a personal issue for me, but I am curious about the reasoning.

WatchMkr, 2019-05-18:
In our view, I/O shields don't match with the rest of the system and are best suited for generic off-the-shelf PC cases rather than a complete product.

eric-s-raymond, 2019-05-18:
I think you have dismissed this issue too quickly.

Part what serious technical buyers are looking for when they acquire a high-end system like this is a certain degree of future-proofness; they want to know that they're going to be able to service and upgrade  it whether or not the vendor is there to help.

Such users put less value on what you think of as a "complete product" positioned like consumer electronics and more on the chassis as the base for a portfolio of options.  Not using a standard cutout is a signal that you don't share this concern.  It clashes with the philosophy of open source and modularity you have expressed elsewhere.

I'm trying to put together an issue addressing a related and slightly larger problem: it seems to me that the Thelio's design reveals a somewhat confused product strategy. I'll have more to say about this when I think I can give crisp and actionable advice.

Closed 2019-05-18.

Thread 12 (2019-05-18):

Thelio case ports need visual contrast so they can be found in dim light.

eric-s-raymond, 2019-05-18:
Black port openings on a black case may appeal to skinny-jeans hipster designers by tickling their ooh-minimalism response, but functionally they suck.  Have mercy on people trying to plug in cables in dim light and cramped spaces.

Silk-screen white outlines around the damn things! Either that or make your port panel(s) out of metal with a finish that is *not black*. Visual contrast is everybody's friend here.

WatchMkr, 2019-05-18:
This is on the product roadmap.

Closed 2021-11-22.

Thread 5 (2019-05-18):

Thelio case needs better noise suppression

eric-s-raymond, 2019-05-18:
I recently moved to a Thelio (generously donated by System76!) from a custom-built system with a high-end sort-of-gamer case called an NZXT (Model 700, I think).  I say "sort-of-gamer" because it used design ideas from gamer hotrod systems while obviously being intended for a broader market - lots of focus on maintainability and upgrade-friendliness in the design.

One axis along which that case was well ahead of the Thelio's is sound suppression.  Besides the now-usual 200mm slow-rotation fans. It did two things future revs of the case could usefully copy:

(1) A thin layer of acoustic foam on the inner walls of the case to absorb sound and dampen case vibrations.

(2) Contract points between assemblies are often (not always, but often) but often acoustically damped by rubber grommets or feet.

If you do these things, it is possible for a Thelio-class system to be whisper-quiet. I miss that about my old system.

magdesign, 2019-05-18:
The noise is really an annoying issue which needs to be resolved.
I will try the rubber idea...

WatchMkr, 2019-05-18:
Thank you for the suggestions. We're working on acoustic improvements in Thelio Io firmware (where we've found lots of potential for optimization) and Thelio mechanical design.

eric-s-raymond, 2019-05-18:
Yeah, that relatively thin case top with no damping on the joints to the base could have been designed as a noise ampilifier.  Grommeting at the joints would address this.

magdesign, 2019-05-18:
I removed this:
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

and added some rubber tape on top:
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

Now to noise is a bit less high....

avollmerhaus, 2019-10-15:
How loud does it usually get? I considered buying a Thelio (the little one), but I can't stand fan noise.
I will be doing some compiling on the system (gentoo user), so it would be a real show stopper if the system is noisy all the time.

magdesign, 2019-10-15:
To be honest, its quite noisy!
I added several rubber tape pieces everywhere to make it more silent, but with heavy rendering I  hear the fans and they speed up and down all the time which makes it really annoying. A constant sound would be a bit less nerve killing....
However, I guess its still one of the best opensource system available.

labeledmk, 2019-11-06:
Some flaws in the design acoustically speaking would be no soft gaskets used, the gap between the chassis and the top shell, the fans. Soft gaskets between vibration points such as fans or the cpu shrouds would help some. The design used on the exhaust and bottom intake are cool but they're thin so you need to isolate them from vibrating as much as possible. The gap on the bottom would be helped with some sort of air filter or being closed altogether. Any open point in the system will leak sound and keeping as much sound coming out of the exhaust as possible will help overall perception of audible sound escaping. The fans are trickier it's a combination of blades, bearing, and fan profiles. Better cooler pulling the heat away from the cpu will mean you can get away with lower RPMs. So thermal paste to something higher their could help though I'm not sure what you do use and how it compares.

WatchMkr, 2020-08-28:
Over the past year and a half, we've worked to dramatically improve the acoustic characteristics of Thelio. We can now confidently close this issue. Most of these changes have been in since late last year. We had a couple more fan curves to optimize when COVID hit which delayed our closing of this issue.

Improving Thelio acoustic quality included component, mechanical, and software changes. To begin the process we built a sound proof room in our factory and acquired testing equipment to measure decibels in a controlled environment. This provided the data necessary to establish a baseline and measure the affect of our changes.

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

**Components**

We have moved to entirely Noctua or Be Quiet fans and coolers. They provide rubber dampening and quieter motors. We use both because supply from only one is not consistent enough. However, we have found that their products perform equally well with regard to cooling and acoustics.

A considerable amount of noise for early shipments of Thelio Major and Massive came from the power supply. EVGA power supplies have a "Eco Mode" that must be turned on to enable a fan curve for the power supply. For Major and Massive customers, please check that Eco Mode is turned on if the power supply seems loud. The switch is either on the back or inside on the power supply. Fan curves on power supplies are now required or enabled on all shipments. Enabling Eco Mode has no affect on performance. It's a silly switch that shouldn't exist.

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

**Mechanical**

Fans are now attached to ducts in the system rather than to the coolers. This reduces transit damage and vibrations when paired with rubber dampeners.

Before
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

After (Also notice the chamber now pulls cool air for Major HEDT CPUs directly from the outside of the chassis. This resulted in better performance and quieter operation.)
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

In early Thelio models, there was a gap between the exterior and interior at the bottom of the machine. We extended the sides of the bottom out to seal the top and bottom of the chassis.

Before
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

After
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

**Software**

While components and mechanical changes contributed to improvements, the biggest improvement came from carefully designed fan curves for each class of product. Fan curve optimizations improved system performance and acoustics. This blog post goes into more detail: https://blog.system76.com/post/618130916327456768/keeping-cool-with-thelio-the-secrets-of-thelios

Being that the biggest contributor to improving Thelio acoustic qualities was software, the improvements have shipped to all Thelio customers through software updates to the system76-power package. All curves for all products have now been optimized and the updates shipped.

Closed 2020-08-28.

Thread 6 (2019-05-18):

Thelio case top is way too hard to put back on once removed.

eric-s-raymond, 2019-05-18:
This is my single worst problem with the Thelio case.  I had to remove the case top to clear a cable that had shifted into an unfortunate collision with a fan blade, and despite many tries and much cursing have not succeeded in getting it reassembled.

Take this seriously, please. I've been tinkering with PCs and their cases since the early 1980s and I have *never before* seen one that was this much of a revolving bitch to put together.  Seems like it requires some combination of secret black magic and the dexterity of a neurosurgeon.

I've been running the machine caseless for days now and this is not good.  My office is dusty and without a case and good filters conductive dust *will* eventually get somewhere that will crash it.  (I used to see this happen occasionally with the Thelio's predecessor.)

This problem is serious enough that I am contemplating transplanting the Thelio's guts into my old case to banish it.

I don't have any clear idea how to fix this.

WatchMkr, 2019-05-18:
Thanks for your input. There are certainly ways we can make that an easier experience.

eric-s-raymond, 2019-05-18:
Maybe start with a YouTube video explaining the black magic?

I'm going to wrestle with the fscker some more later today.

brs17, 2019-05-20:
@eric-s-raymond guides/videos for working on Thelio can be found here: https://system76.com/guides

eric-s-raymond, 2019-05-20:
I see links for three Thelio variants there.  How do I tell which one mine is?

WatchMkr, 2019-05-20:
There is a badge on the back of the computer with your model number.

Closed 2019-05-18.

Thread 7 (2019-05-18):

Air intakes need removable dust filters

eric-s-raymond, 2019-05-18:
See issue #6 for backstory.  Without intake filters my Thelio is going to choke on the dust - the question is only when, not if.

When you design these in, do it so that (a) the intake filters slide out for cleaning, and (b) they can be removed and reinserted with the machine in its normal operating position.

My old case had this feature. It was wonderful.

WatchMkr, 2019-05-18:
This is on the roadmap.

Thread 8 (2019-05-18):

Thelio case needs indentations or handles for lifting

eric-s-raymond, 2019-05-18:
Title says it all.

The nice custom Unix epoch zero fan grille on mine is slightly bent inwards because the top of it was the only place my fingers could get purchase when I was trying to shift the thing. I am sad about this.

I don't much care functionally whether the grips or indented portions are fore and aft near the top  of either end of the lower frame or on either side of the case top.  The fore-and-aft placement would probably be better structural engineering, as it would avoid hanging the weight on the lower frame off of six relatively small thumbscrews.

WatchMkr, 2019-05-18:
Thank you for the suggestion. We'll keep this in mind as we continue to iterate the design.

magdesign, 2019-05-18:
May sound a bit silly but,
look out for some old MacPro mid2010 on ebay.
Their case is beautifully designed, very easy to open, everything exchangeable without tools, very silent and they are not in production anymore.... just for inspiration..

eric-s-raymond, 2019-05-18:
Yeah, those middle-period Mac cases were excellent design for usability/maintainability.

If you want real positive differentiation this is the direction I urge you to go - make people think "motherboards age out but I want to keep this case forever".  My old NZXT case is like that.

Thread 9 (2019-05-18):

Thelio case lacks front- or top-mounted USB ports.

eric-s-raymond, 2019-05-18:
Lack of front- or top-mounted USB ports is annoying.

You may not think this is a big deal, but I use a very common Logitech trackball called an m570, a wireless device with a USB radio dongle. It can matter a lot whether that device is on the front, top, or back of the machine, because the low-power radio transceiver has trouble if it's too far away from or not in LOS with the trackball.

You're competing with cases that have  this. It's pretty much a checklist feature for the high-end ones these days; you shouldn't get left behind.

WatchMkr, 2019-05-18:
Front ports are on the product roadmap.

michalsapka, 2022-10-26:
Was this abandoned in the redesign process?

leviport, 2023-10-17:
Front (well, top-front) ports have been added in the latest iteration of the Thelio/Nebula designs: https://github.com/system76/thelio/pull/59

Closed 2023-10-17.

Thread 14 (2019-06-09):

Thelio connector pins for the front button are too fragile

eric-s-raymond, 2019-06-09:
Related to #6.  I had a buddy who troubleshoots industrial computers for a living assist me in getting the case top back on the Thelio, because I couldn't.  He poked around it a bit and said "Here's part of your problem" and then temporarily removed the part so I could photograph it.

https://photos.google.com/photo/AF1QipO0v9uXa0A30XOwsFC5C_b6ZmDwUw3SuV9XHU9b

Note the bent pins.  It's obvious what happened; during one or more of my futile, profanity-laden attempts to refit the case top, they were misaligned and got mashed. My friend straightened then with a needlenose.

His verdict "Somebody got too cute." He thinks that should have been done with a conventional cable and a plug, rather than making the mating of the connector halves rigidly dependent on the alignment of the case top when it's pushed down - that was just asking for the failure mode presented at the image link.  I agree.

In my opinion as an experienced PC builder myself, altogether too much of this case design needs to be shot and buried under a gravestone labeled "Somebody got too cute". Some of the ideas are really good, like the custom vertical drive cage.    Some  are insubstantial but fun, like the encoding of the Unix epoch in the rear fan grille.  But there's too much about it that smacks of designers doing things because they could, without pondering whether they should.

Please think harder about serviceability and minimizing avoidable mechanical failure modes next time.

WatchMkr, 2019-06-09:
Thanks for providing your opinion. We appreciate the feedback.

Closed 2019-06-09.

Thread 15 (2019-11-19):

Thelio case quality after one year of usage

magdesign, 2019-11-19:
This is meant as constructive feedback!

After one year of usage  my Thelio case is loosing its shape.
The wooden foil starts to get blisters and the edges start to bend upwards.

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

You should seriously think about material thickness, quality check and have some talks with people who work with metal parts every day (the ones who get dirty hands). Then bring an updated version of the case and maybe some ideas for us to fix some issues.

As soon as I have more spare time, I will start upgrading my Thelio case to be much more quit since the noise level is still the biggest issue..... will post my progress here...

WatchMkr, 2019-11-19:
Thanks for the feedback! We have made a large number of changes in both process and design for exactly these things that we've seen. If you'll please reach out to customer support, we'll be happy to exchange your exterior.

Regarding the noise level, last Friday we shipped a software update that reduced the audible fan noise by 7 decibels. The update is to a software package called system76-power. Are you running Pop or Ubuntu? Have you made any changes to the wiring in the case?

You can check the check the system76-power version with the following command (version ending with 1a6e703 has the update):

pop@pop-os:~$ apt-cache policy system76-power
system76-power:
  Installed: 1.0.1~1573832218~19.10~1a6e703
  Candidate: 1.0.1~1573832218~19.10~1a6e703
  Version table:
 *** 1.0.1~1573832218~19.10~1a6e703 1001

magdesign, 2019-11-19:
Running Pop-os 18.04 LTS
checked the system76-power version:
`system76-power is already the newest version (1.0.1~1570998296~18.04~d0013c0)`
Is 1a6e703 only available for 19.10 users ?

I might come back to your offer for a case replacement, thanks!

WatchMkr, 2019-11-19:
We're backporting the new fan curves to Pop!_OS 18.04 now. You should see the update by the end of the week.

WatchMkr, 2019-11-21:
The new fan curves have been released in Pop 18.04. Run updates and check for version `system76-power_1.0.1~1574207757~18.04~4f6a818` with the command `apt-cache policy system76-power`.

You should notice a considerable difference.

Again, thank you for the feedback. We are pretty confident we've addressed both the veneer adhering and case rigidity with updates over the past year. I'm going to go ahead and close the issue for now.

magdesign, 2019-12-19:
The new curves are amazing, great work!

Closed 2019-11-21.

Thread 18 (2021-01-05):

BOM (Bill of Materials) is Missing Thelio-R2

pmgcrypto, 2021-01-05:
I just glanced over the BOM in Common. Looks like you're missing the components for the Thelio-R2.

Closed 2021-11-22.

Thread 20 (2021-07-08):

New top case brace

jgrano, 2021-07-08:
Move R&D thelio top case brace into a productive task.

jgrano, 2021-07-08:
Working on rough design 7/8/21

jgrano, 2021-07-12:
Design has been made.
Ready for review & modification.

https://a360.co/3hVGjaE

CCooper20, 2021-07-20:
Main alumn. plate has been machined and welded brackets (7/19/21)
Waiting on new 1/4" reamer to loosen up bracket pin holes (tight fit now)
Wed (7/21/21) will machine out tapped brackets (need to program and machine)

@jgrano do we need to create a WI for this fixture?

@jgrano / @CaryHertert And adding a check box for when you get the parts to etch ID on brackets.

- [ ] Etch welded brackets with ID
- [ ] Etch tapped brackets with ID

jgrano, 2021-07-20:
@CCooper20 we should make a WI for this after we have flushed it out. Being that we're still heavily in the R&D setup here I think it will likely change before we get done.

I like the check mark feature for the etching.

Closed 2021-11-22.

Thread 21 (2021-07-08):

CPU Duct - Move fan down 5mm for thermal testing

jgrano, 2021-07-08:
THEALU-010010 -- seems to work based on Levi's initial testing. Needs mfg refinements.

CaryHertert, 2021-08-04:
@jgrano can you help clarify this task?  is this fan and duct and back panel vent?

jgrano, 2021-08-05:
@CaryHertert Part THEALU-010010 is in ThelioV2, material is regretfully mis-assigned as 0.63" and I cannot quickly change to 1.6mm standard material. The profile either needs to be rebuilt or THEALU-010009 needs to change.

Closed 2021-11-22.

Thread 25 (2021-07-08):

Test new GPU brace. The current quad GPU brace was found to improve thermal performance with four GPUs. Ensure there is no regression before implementing the new brace.

jgrano, 2021-07-08:
Look into issue

Closed 2021-11-22.

Thread 29 (2021-07-08):

Replace Rivnuts, perhaps with pemcerts.

jgrano, 2021-07-08:
Need more info

jgrano, 2021-07-08:
@CaryHertert please add the email quote info

CaryHertert, 2021-07-09:
[PEMEdge CSI.pdf](https://github.com/system76/thelio/files/6788567/PEMEdge.CSI.pdf)
[PEMEdge lab services.pdf](https://github.com/system76/thelio/files/6788568/PEMEdge.lab.services.pdf)
[Line Card.pdf](https://github.com/system76/thelio/files/6788569/Line.Card.pdf)

jgrano, 2021-07-27:
@CaryHertert Can we look at finding a few standard parts (m3 nut inserts etc..) that we can push out to sourcing? I think we need to run through a few more samples and get an order together for ~50k of each from China.

Closed 2021-11-22.

Thread 31 (2021-07-08):

New External Case design/assembly method

jgrano, 2021-07-08:
Looking at laser welding panels - Parts shipped 4/23 - JG
If works  - laser weld/bend fixtures from sm

Single piece top brace design in process 4/27

Sample built w/approval 5/4
working on trumpf marking levels for alignment profile.

powder complete unit 5/4

jgrano, 2021-07-19:
Moved to #20

Closed 2021-07-19.

Thread 37 (2021-07-08):

Prototype new silicone feet

jgrano, 2021-07-08:
Added Spacers to quote, waiting to pull trigger 4/23/21

jgrano, 2021-07-23:
Should see final samples with 1st shipment of KEYALU-001001 from Frank. Will update on 1st articles before order.

jgrano, 2021-08-02:
Submitted approval for both feet & spacers.

Will order longer mounting screws as well at this point from china.

Closed 2021-08-02.

Thread 38 (2021-07-08):

Mylar bags for veneer

CaryHertert, 2021-07-08:
Found these [U-Line mylar bags](https://www.uline.com/Product/Detail/S-23408/Food-Bags/Metalized-Food-Bags-Reclosable-20-x-29)
and these (Amazon) [dessicant bags](https://www.amazon.com/O2frepak-200Packs-Moisture-Absorber-Desiccant/dp/B08QV3F7B1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)

Production cant store cut veneer because it expands as it absorbs moisture.

cfiedler76, 2021-07-09:
Thanks, Cary!  This is a great idea.  I’ll touch base with May and see if we can get these ordered.  I think we also get this silica packs with the key switches, so it could be great to also reuse those instead of throwing them away.

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

Closed 2021-11-22.

Thread 39 (2021-07-15):

Cut Prototype # 2

jgrano, 2021-07-15:
Round 2

jgrano, 2021-07-15:
Export files to TT Design cut/bend programs and run.

Need qty - 2 units, 1 full powder and build for thermal testing.

jgrano, 2021-07-19:
Made 3 units.

2 into powder for full build
1 as a gut check in ME for review

jgrano, 2021-07-23:
Units have been handed off to Production & QC for testing. Initial feedback from Production is good.

Will need full thermal loading tests/acoustic performance tests, will also need to compare to config from previous R2 tests as a base line.

To update @brs17 and @WatchMkr with initial results from @leviport next week

jgrano, 2021-07-29:
Will likely need to move the 2nd drive cage down to avoid the largest of the gpu's that work.

Closed 2021-11-22.

Thread 40 (2021-07-23):

Thermal Testing on Major V3 Chassis

jgrano, 2021-07-23:
Verify Thermal performance with V3 chassis vs V2.

leviport, 2021-08-02:
I'm still waiting on the thick spinner drives, but here's my evaluation so far.

With two non-blower cards installed (2080 and 2080Ti), I was able to make the CPU throttle some while stressing the CPU, RAM, and both GPUs at the same time. If I only stressed the CPU and RAM, the CPU would hover around 93°C and run at full speed. The GPU in the top slot (the 2080 in this case) throttled quite a bit after about 10 minutes of stressing, but that's not a surprise since it's a non-blower with another non-blower directly below it.

When I switched the GPUs out for two blower cards (both were 2080Ti's), things got much better. The CPU and both GPUs would get close to their max temps, but throttling was extremely minimal.

leviport, 2021-08-04:
We received the drives and began testing. We loaded all 4 into the top bay first. The drives jumped up to 55°C very quickly. In prior testing, they started keeling over if they got much above that, so I halted the test.

The fan does not fit over the top of this bay with the top case on, so I haven't been able to test that yet. I might drill new holes to move this drive bay down a bit so I can get it in there.

I will test the lower bay next. Since it's right next to the bottom intake fan, I want to see how it does with out the 90mm cover fan first.

leviport, 2021-08-04:
The drives seem to be staying plenty cool in the lower bay without the 90mm fan lid. Current max temp is 43°C after about 5 hours of stressing. So if we end up needing the fan lid, it'll only be needed on the top bay.

jgrano, 2021-08-05:
So to accommodate the 1% of users that will utilize all 8 bays I will move the upper cage down to be able to handle a 90mm fan.

jgrano, 2021-08-05:
@brs17 @leviport This would need to get integrated into the catalog as well as associated with only adding for the fully loaded spinning disk systems -

https://noctua.at/en/nf-a9x14-pwm-chromax-black-swap

brs17, 2021-08-05:
> @brs17 @leviport This would need to get integrated into the catalog as well as associated with only adding for the fully loaded spinning disk systems -
>
> https://noctua.at/en/nf-a9x14-pwm-chromax-black-swap

For sure. V3 update will require at least one other catalog update as well. As we get closer to being ready with V3, all of that will need to be figured out, those fans sourced/priced, V2s phased out, and production brought up to speed in regards to transitioning to V3.

leviport, 2021-08-06:
I'd like to test the drive cover with the fan when it's ready, but I believe that's the last remaining thermal question remaining with this prototype.

jgrano, 2021-08-10:
@leviport I can't seem to make a 90mm fan work right for mounting with the cage as it is now. I'm going to try building around a NF-A6x25 pwm Noctua fan. I think it will push enough air and actually have the right pattern for me to mount.

jgrano, 2021-08-18:
Scrapping lower cage location and pushing parts backup. Per recheck of old thermals

Closed 2021-11-22.

Thread 42 (2021-07-27):

Thelio V3R2 - 2 piece chassis

CaryHertert, 2021-07-27:
see mira for reference

jgrano, 2021-07-29:
Maintain all case dimensions for Thelio, internals can change.

CaryHertert, 2021-09-01:
implemented in V3 design

Closed 2021-09-01.

Thread 46 (2021-08-20):

create drawing binder for thelio workstations

CaryHertert, 2021-08-20:

CaryHertert, 2021-09-21:
[THEALU-030001.pdf](https://github.com/system76/thelio/files/7205946/THEALU-030001.pdf)
[THEALU-031001.pdf](https://github.com/system76/thelio/files/7205947/THEALU-031001.pdf)
[THEALU-032001.pdf](https://github.com/system76/thelio/files/7205948/THEALU-032001.pdf)
[THEALU-033001.pdf](https://github.com/system76/thelio/files/7205949/THEALU-033001.pdf)
[THEALU-034001.pdf](https://github.com/system76/thelio/files/7205950/THEALU-034001.pdf)
[THEALU-035001.pdf](https://github.com/system76/thelio/files/7205951/THEALU-035001.pdf)
[THEALU-036001.pdf](https://github.com/system76/thelio/files/7205952/THEALU-036001.pdf)
[THEALU-037001.pdf](https://github.com/system76/thelio/files/7205955/THEALU-037001.pdf)
[THEASY-030001.pdf](https://github.com/system76/thelio/files/7205957/THEASY-030001.pdf)
[THELIO BOM - Sheet1.pdf](https://github.com/system76/thelio/files/7205958/THELIO.BOM.-.Sheet1.pdf)

@s-mcnees this is the plan for Thelio V3.  Will run 5x prototypes when PCI Mounts have been prototyped and PEM inserts arrive.  I will create a new GIT issue to assemble and review prototypes with production and assembly then.

Closed 2021-11-22.

Thread 47 (2021-08-26):

ThelioV3 Prototype Revisions:

CaryHertert, 2021-08-26:
- [x] back panel:  side holes should be PEMs

- [x] back panel:  corners should be PEM
-  [x] back panel:  increase standoff clearance in middle of panel.
- [x] back panel:  move drive cage lower
- [x] back panel:  screws hit extrusion.
- [x] base:  add PEMs to back side
- [x] make PCI bracket
- [x] case brace:  reduce o'all length by 2x rivnut flanges
- [x] side PEM standoffs: check antenna standoff hole size
- [x] side:  check head clearance for feet
- [x] GPU Brace:  check bracket range
- [x] GPU Brace:  should be M4 clearance, dont need extensions

CaryHertert, 2021-08-31:
next revisions:

- [ ] make access for gpu bracket from the side (cut clearance in the base flange)
- [ ] make 3070 gpu fit by making another version of gpu brace?
- [ ] move sheet metal pci bracket toward mobo by 1mm
- [ ] add 4 screws to case brace
- [ ] move case brace down 2.85mm to bring drive cage fastener heads flush with top
- [ ] remove gpu clearance holes from chassis side.

CaryHertert, 2021-09-01:
changing pci bracket flange instead of moving mounting holes.  Moving to prototype 3

Closed 2021-09-01.

Thread 48 (2021-08-26):

prototype build 2

CaryHertert, 2021-08-26:
cut/press/bend:  [ThelioV3 Sheet Metal](https://www.dropbox.com/sh/epomj777bvbwzg9/AACb0xHzzyASob8yq6susX8wa?dl=0)
- [ ] PCI Bracket (THEALU-TBD4v9.step)
- [ ] Side (THEALU-TBD2 v40)
- [ ] Back (Thelio Back Panel v32.step)
- [ ] Base (THEALU-007004 v10.step)
- [ ] GPU Bracket (gpu brace v26.step)
- [ ] Brace (support bracket v29.step)
- [ ] CPU Duct (cooler2 v6.step)

And assemble

CaryHertert, 2021-09-01:
prototype built and assembled.  modifications captured for P3.

Closed 2021-09-01.

Thread 49 (2021-09-01):

Prototype Build 3

CaryHertert, 2021-09-01:
cut/bend prototype 3 components, 3 of each part.

https://www.dropbox.com/sh/wix64lzis58i90y/AADXITzAoZLguh6FOXASUDcga?dl=0

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

CaryHertert, 2021-09-02:
- [ ]  antenna standoff holes are too large.  MoBo standoff holes are too small.

Closed 2021-11-22.

Thread 51 (2021-09-09):

Change chassis brace to 316.5mm width, correct offset from side of chassis, make new production part MRAALU_008006

jgrano, 2021-09-09:

Closed 2021-11-22.

Thread 52 (2021-11-23):

Clean up solar system for 90 & 120mm fan, DFM for Trumpf and no splines.

jgrano, 2021-11-23:
equal spacing for rings, smaller portions

jgrano, 2021-11-23:
Need to build out a similar design for both sized holes on the Thelio line. Once it's ready on it's own w/testing implement on the entire line and cut new back panels.

leviport, 2023-10-17:
I believe this is complete

Closed 2023-10-17.

Thread 53 (2022-02-02):

Fan connectors to improve duct installation and removal

CaryHertert, 2022-02-02:
Fan connectors to improve duct installation and removal. Thelio Io fan headers plug into connectors near the duct. Fans on the duct plug into the opposite connector. Installing the duct connects the fans to the Thelio Io. Needs to be modular to grow from one fan to six. (per carl)

CaryHertert, 2022-02-02:
@WatchMkr I am picturing the fans (1-6) loaded in to the duct and the assembly installed in to the machine as a unit.  Will the fan/duct assembly be connected to the IO via board to board connector or wire?

leviport, 2023-10-17:
Now that the two CPU fans connect to the small splitter board, I believe this issue is solved

Closed 2023-10-17.

Thread 55 (2022-05-07):

Thelio intake fan produces annoying sound on spin-down

sopadelata, 2022-05-07:
The be be quiet! 14025-hf-pwm fan that Thelio uses for its intake is quite noisy, particularly when spinning down. It produces an audible "rattly" noise. I uploaded a video below. Not all speakers seem to reproduce the noise well, so.. headphones recommended I guess? I promise it's much more audible in real life! I'm probably going to end up replacing the fan on my Thelio. I experienced the issue on another Thelio so I know it's not just a one-off defect.

https://user-images.githubusercontent.com/104468204/167266412-bfd651e3-f7cb-4ad3-a97c-55df42f1d9d5.mp4

.

sopadelata, 2022-05-12:
I ended up replacing the fan with a Noctua NF-A14. This fan moves more air but is also, on paper, louder. However, it's still very quiet to my ear, even with the case panel off and in a quiet house with a low noise floor. In addition, it does not produce the "rattling" noise that the be quiet! fan does. The cable is also an appropriate length for connecting to Thelio IO
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
.

alanmrvl, 2022-10-15:
I've been having the same problem with my fans
