system76/thelio/Thelio Common/Screws and standoff/15mm rubber case feet with m4 thread insert.PDF

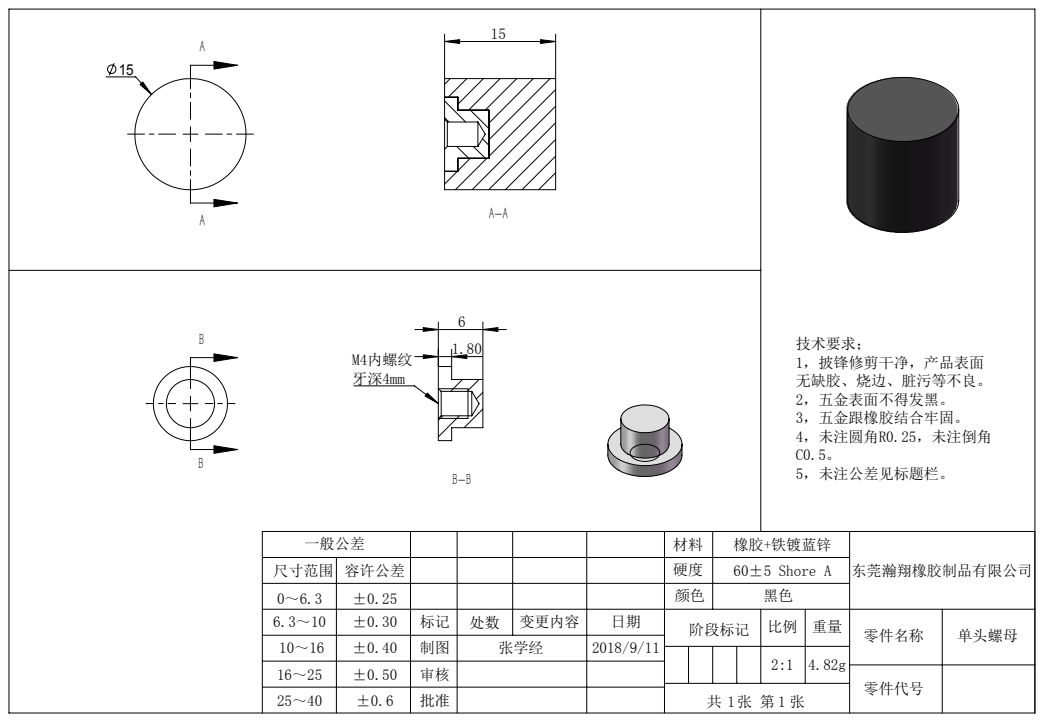
[picture p35: page 1]

一般公差 | | | | | 材料 | 橡胶+铁镀蓝锌 | 东莞瀚翔橡胶制品有限公司
尺寸范围 | 容许公差 | | | | | 硬度 | 60±5 Shore A
0～6.3 | ±0.25 | | | | | 颜色 | 黑色
6.3～10 | ±0.30 | 标记 | 处数 | 变更内容 | 日期 | 阶段标记 | 比例 | 重量 | 零件名称 | 单头螺母
10～16 | ±0.40 | 制图 | 张学经 | | 2018/9/11
16～25 | ±0.50 | 审核
25～40 | ±0.6 | 批准

零件代号
