system76/thelio/(commit log)

2018-11-01 Add Thelio Massive
    [Cage 1 V1.step, Cage 2 V1.step, E1 V2.step, E2 V2.step, E3 V2.step, E4 V4.step, Front V1.step, Side 1 V1.step]
2018-11-01 Update Thelio Massive
    [Bottom V1.step, Brace V1.step, CPU Bracket V1.step, Cage 2 V1.step, Internal V1.step, PCI Bracket V1.step]
2019-05-21 Add Thelio Major V2
    [Bottom V1.step, Brace V1.step, CPU Duct V1.step, Cage 1 V1.step, Cage 1 V2.1.step, Cage 2 V1.step, Cage 2 V2.1.step, Front V1.step]
2020-10-20 Mega (#17)
    * Add Thelio Mega
    * Production Launch
    Update files to match production launch
    * Fix Errors
    fixed some naming errors on step file
    [MGAALU-001001.step, MGAALU-002001.step, MGAALU-003001.step, MGAALU-004001.step, MGAALU-009005.step, MGAALU-011003.step, MGAALU-011004.step, MGAALU-012010.step]
2021-02-15 Add Thelio Mira (#19)
    [MRAALU-001001.step, MRAALU-002001.step, MRAALU-003001.step, MRAALU-004001.step, MRAALU-005003.step, MRAALU-006003.step, MRAALU-008002.step, MRAALU-009002.step]
2023-07-19 Update Thelio Main/nebula19 and Mira/nebula36 case design
    [Bottom Tray V1.step, Brace V1.step, CPU Duct V1.step, Cage V1.step, E1 V2.step, E2 v2.step, E3 v2.step, E4 v4.step]
2023-07-19 Update Thelio Major/nebula49 case design
    [Bottom V1.step, Brace V1.step, CPU Duct V1.step, Cage 1 V1.step, Cage 1 V2.1.step, Cage 2 V1.step, Cage 2 V2.1.step, E1 V2.step]
2023-10-09 Update for Nebula V2 and Thelio-Spark
    [PN-000094 v19.step, PN-000094 v6.step, PN-000122 v12.step, PN-000156 v15.step, PN-000175 v6.step, PN-000255 v15.step, PN-000259 v2.step, PN-000335 v7.step]
2024-03-26 Added Mira/Spark (nebula39) Extended Design
    [Mira Case N3 - Accent case extended 40 mm v3.step, PN-000094 v19.step, PN-000122 v12.step, PN-000255 v15.step, PN-000259 v1.step, PN-000459 v14.step, PN-000512 v13.step, PN-000525 v17.step]
2024-05-24 Renamed files for windows use
    [Mira Case N3 - Accent case extended 40 mm v3.step, PN-000094 v19.step, PN-000122 v12.step, PN-000255 v15.step, PN-000259 v1.step, PN-000259 v2.step, PN-000335 v7.step, PN-000376 v24.step]
2024-06-04 Update step files
    [Mira Case N3 - Accent case extended 40 mm v3.step, Mira Extended Assembly (N3) v16.step, PN-000094 v19.step, PN-000101 v18.step, PN-000122 v12.step, PN-000255 v15.step, PN-000259 v1.step, PN-000259 v2.step]
2024-06-24 Adding new Thelio Mega design
    Updating Thelio Mega directory structure.
    [GPU Mega Fan Brace v8.step, MGAALU-001001.step, MGAALU-002001.step, MGAALU-003001.step, MGAALU-004001.step, MGAALU-009005.step, MGAALU-011003.step, MGAALU-011004.step]
2024-09-13 Add step files for thelio astra
    [Mira Case N3 - Accent case extended 40 mm v3.step, Mira Extended Assembly (N3) v16.step, PN-000094 v19.step, PN-000101 v18.step, PN-000122 v12.step, PN-000255 v15.step, PN-000259 v2.step, PN-000457 v17.step]
2024-12-19 Mega n3 design (#64)
    * removing Thelio Io submodule
    * Add thelio-io versions 1 and 2
    * Add new Thelio Mega design files
    * Adding parts list index
    * Add new Mega N3 chassis design & update other systems
    [Bottom V1.step, Brace V1.step, CPU Bracket V1.step, Cage 1 V1.step, Cage 2 V1.step, E1 V2.step, E2 V2.step, E3 V2.step]
2025-09-11 Directory restructure for new Mira design
    [Mira Case N3 - Accent case extended 40 mm v3.step, Mira Extended Assembly (N3) v16.step, PN-000094 v19.step, PN-000101 v18.step, PN-000122 v12.step, PN-000255 v15.step, PN-000259 v2.step, PN-000335 v7.step]
2025-12-04 Update README and add STEP files
    [2x cage assembly v20.step, External Magnet Con Holder v6.step, Internal Magnet Con Holder v4.step, Lower Foot v4.step, Mesh Bracket-small v11.step, Mesh Side Mount BKT v2.step, Mesh Top Mount BKT v2.step, Mesh Update v9.step]
2026-09-23 Add new Thelio Prime N2 STEP files. (#68)
    [PN-000009 v42.step, PN-000010 v23.step, PN-000252 v17.step, PN-000257 v3.step, PN-000505 v36.step, PN-000506 v21.step, PN-000507 v61.step, PN-000509 v36.step]
